Arvad/YbDDSControl/DDSbox/wiki_related/004_amplitude_tuning.jpg

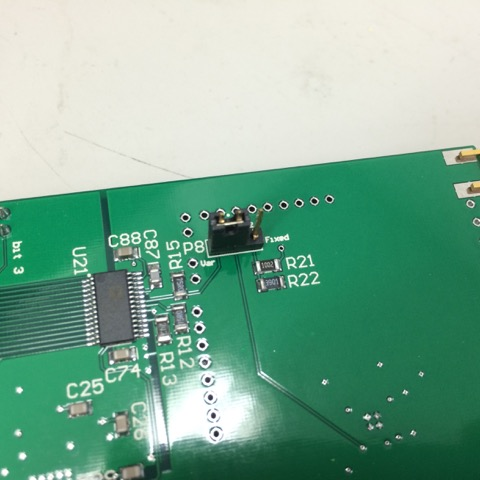
DDSbox/wiki_related/004_amplitude_tuning.jpg
