Arvad/YbDDSControl/DDSbox/wiki_related/gallery/UCLA_setup.jpg

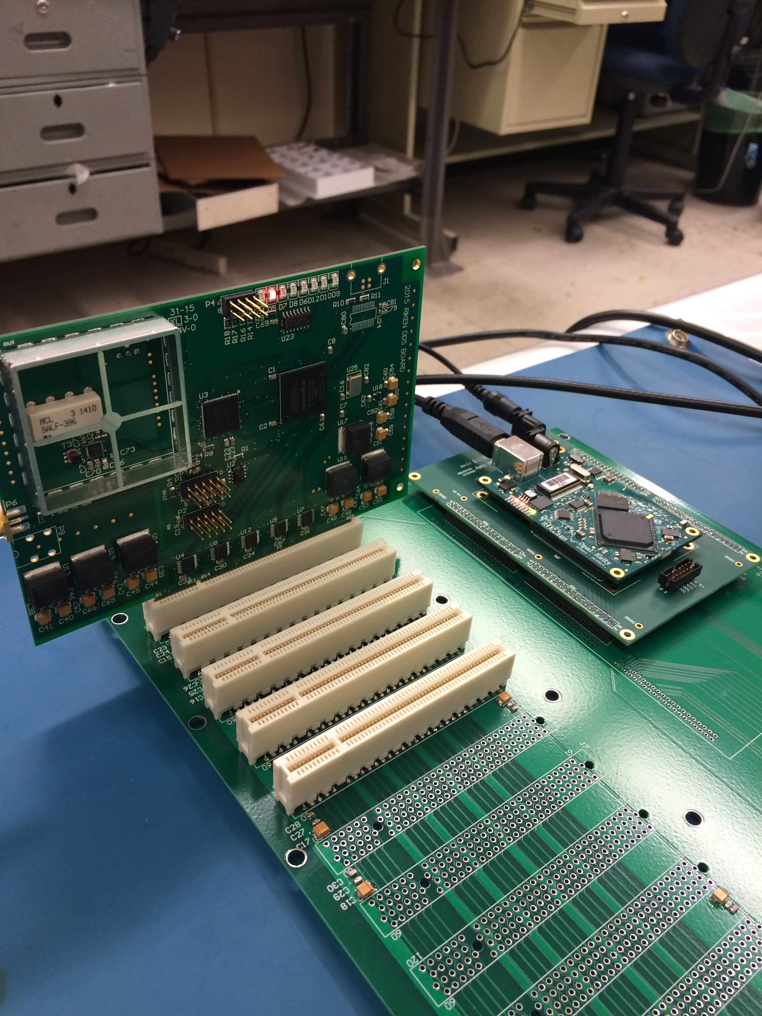
DDSbox/wiki_related/gallery/UCLA_setup.jpg
