Arvad/YbDDSControl/DDSbox/README.md

# Files for the DDS box (Both main Opal Kelly FPGA and dds boards (Cyclone FPGA))
Schematics
VhDl files
