Arvad/YbDDSControl/DDSbox/wiki_related/001_blank_LabRAD.tiff

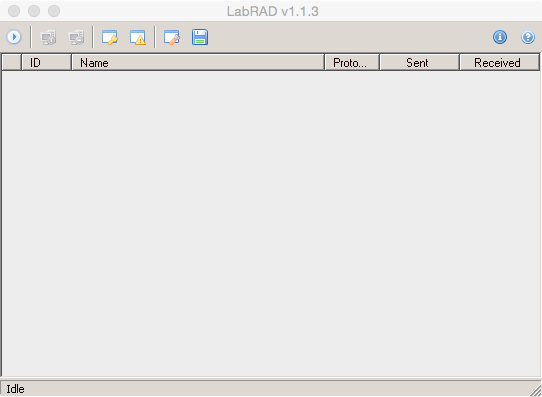
DDSbox/wiki_related/001_blank_LabRAD.tiff
