Arvad/YbDDSControl/DDSbox/wiki_related/002_initial_LabRAD.tiff

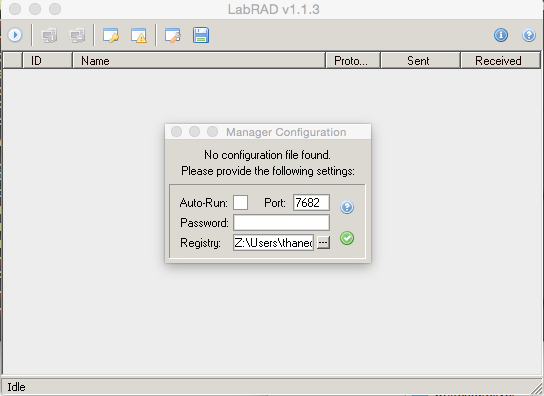
DDSbox/wiki_related/002_initial_LabRAD.tiff
