Arvad/YbDDSControl/DDSbox/wiki_related/005_DDS_GUI_sample.jpg

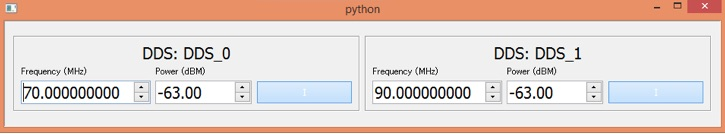
DDSbox/wiki_related/005_DDS_GUI_sample.jpg
