Arvad/YbDDSControl/DDSbox/wiki_related/006_frequency_ramp.jpg

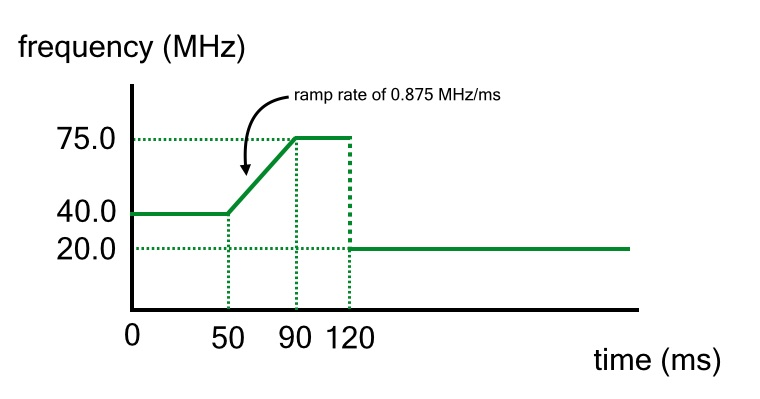
DDSbox/wiki_related/006_frequency_ramp.jpg
