Arvad/YbDDSControl/DDSbox/wiki_related/007_pin_connection.tiff

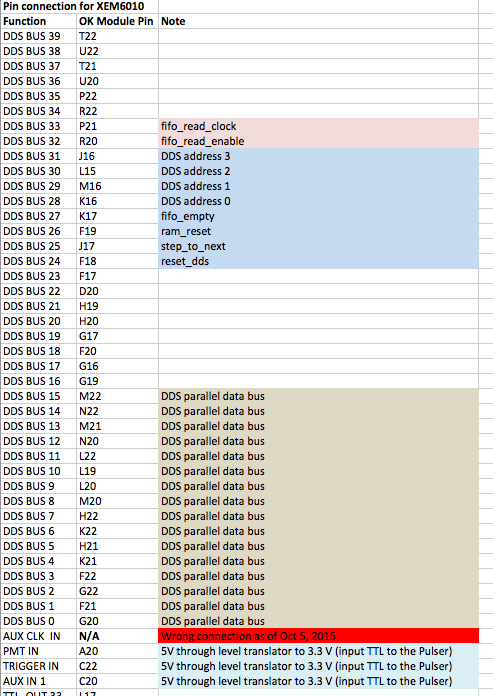
DDSbox/wiki_related/007_pin_connection.tiff
