Arvad/YbDDSControl/DDSbox/wiki_related/008_programming.tiff

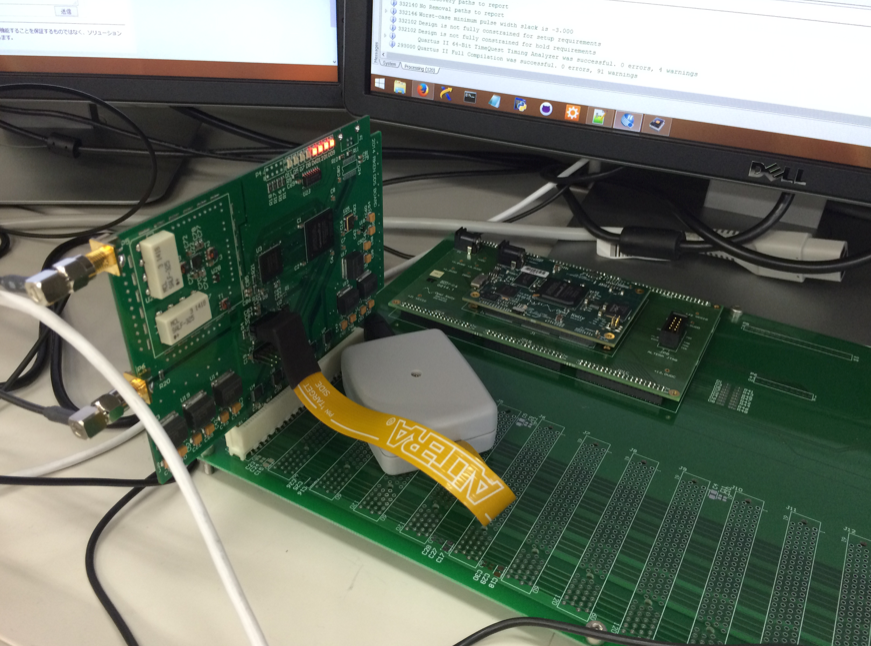
DDSbox/wiki_related/008_programming.tiff
