Arvad/YbDDSControl/DDSbox/wiki_related/010_moving_lattice_freq_curves.tiff

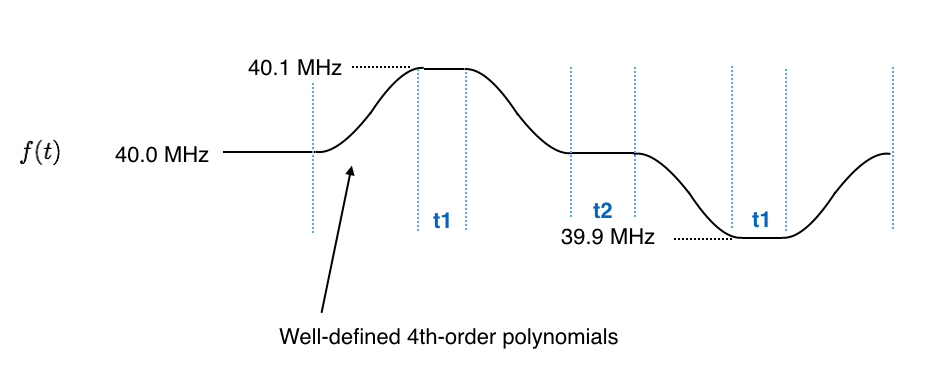
DDSbox/wiki_related/010_moving_lattice_freq_curves.tiff
