Arvad/YbDDSControl/DDSbox/wiki_related/011_moving_lattice_dds_boards.tiff

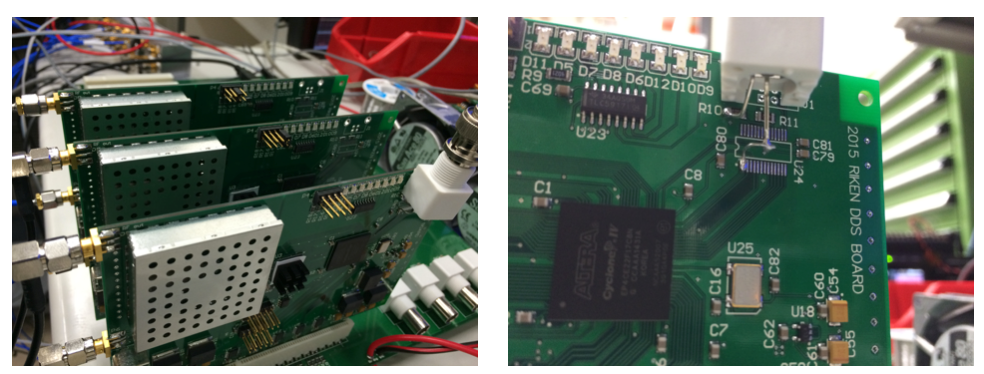
DDSbox/wiki_related/011_moving_lattice_dds_boards.tiff
