Arvad/YbDDSControl/DDSbox/wiki_related/gallery/Berkeley_2012.tiff

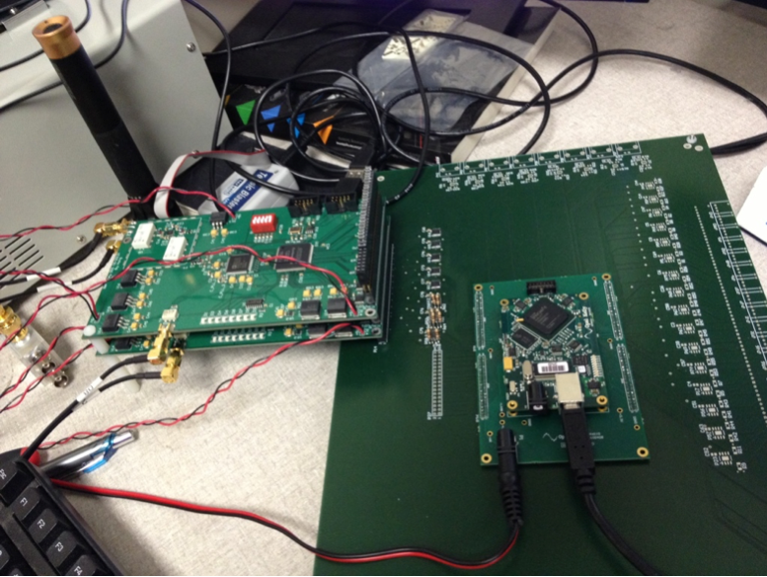
DDSbox/wiki_related/gallery/Berkeley_2012.tiff
