Arvad/YbDDSControl/DDSbox/wiki_related/gallery/Berkeley_2012_DDS_board.tiff

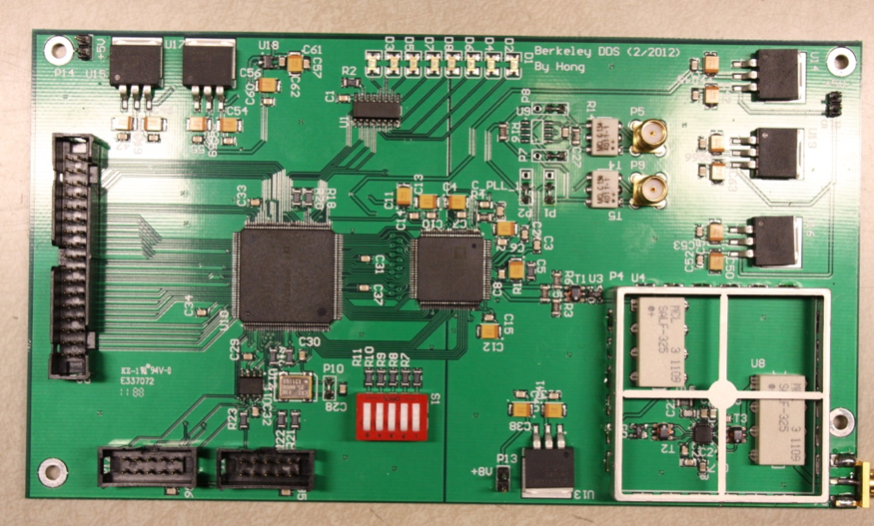
DDSbox/wiki_related/gallery/Berkeley_2012_DDS_board.tiff
