Arvad/YbDDSControl/DDSbox/wiki_related/gallery/RIKEN_2014_version.jpg

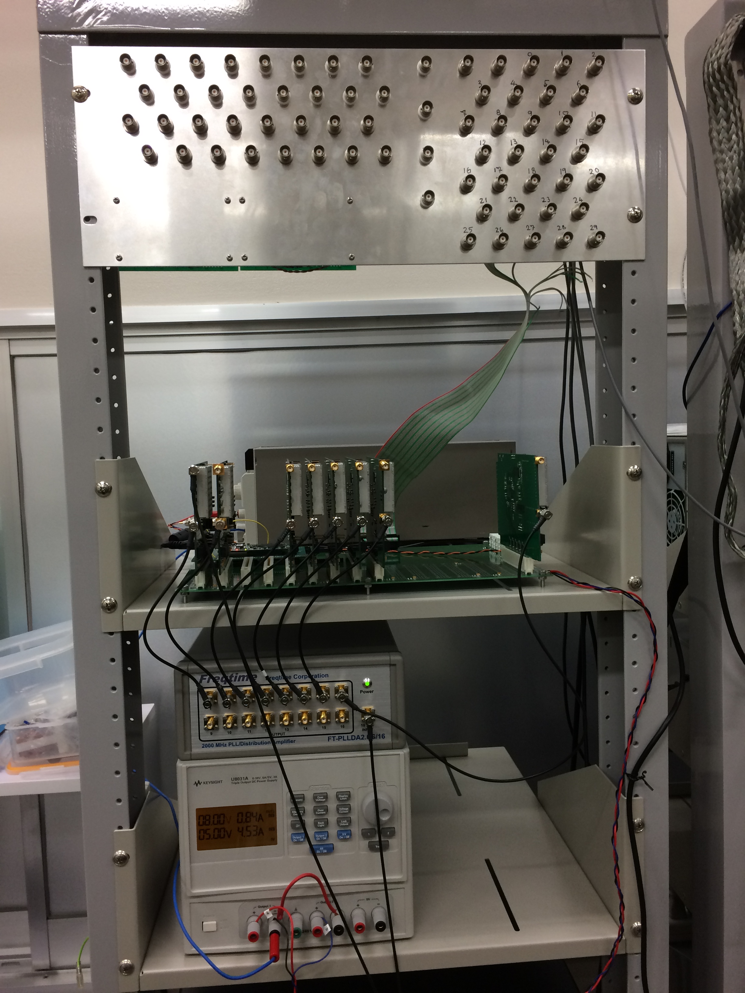
DDSbox/wiki_related/gallery/RIKEN_2014_version.jpg
