Arvad/YbDDSControl/DDSbox/PCB_designs/DDS_board/2016_Feb/Components_list.xlsx

DDS 2015 components list
No. of boards | 120
Components
Footprint | Description | Comment | Designator | Value | Quantity per board | Total quantity | Install? | Link | Arrived? | Arrived quantity | Required
CAPC2012L | Cap Semi |  | C1, C2, C3, C4, C5, C6, C7, C8, C9, C10, C15, C16, C17, C18, C19, C20, C21, C24, C25, C26, C27, C28, C29, C30, C31, C32, C33, C34, C35, C36, C37, C40, C41, C44, C45, C48, C49, C52, C53, C58, C59, C60, C61, C65, C66, C67, C68, C69, C70, C71, C72, C73, C75, C82 | 100nF | 54 | 6480 | Yes |  | Did not order
CAPC2012L | Cap Semi |  | C11, C12, C13, C14 | 10pF | 4 | 480 | Yes
CAPC2012L | Cap Semi |  | C22 | 560pF | 1 | 120 | Yes | http://www.digikey.jp/product-search/ja?KeyWords=399-9254-1-ND%20&WT.z_header=search_go
CAPC2012L | Cap Semi |  | C23 | 470nF | 1 | 120 | Yes
B | Cap Pol1 |  | C38, C39, C42, C43, C46, C47, C50, C51, C54, C55, C56, C57, C63, C64 | 10uF | 14 | 1680 | Yes | http://www.digikey.jp/product-detail/ja/T491B106M025AT/399-9721-1-ND/3724699 | Yes | 2000 | 560
CAPC2012L | Cap |  | C62 | 100nF | 1 | 120 | Yes |  |  |  | 40
c0805 | Cap |  | C74, C83, C84, C88 | 100nF | 4 | 480 | Yes |  |  |  | 160
c0805 | Cap |  | C76, C87 | 100pF | 2 | 240 | Yes |  |  |  | 80
c0805 | Cap |  | C77, C78 | 10nF | 2 | 240 | Yes | http://www.digikey.jp/product-search/ja?KeyWords=399-5706-1-ND%20&WT.z_header=search_go |  |  | 80
CAPC2012L | Cap Semi |  | C79, C80, C81 | 33nF | 3 | 360 | Yes |  |  |  | 120
c0805 | Cap | C0G special | C85, C86 | 47nF | 2 | 240 | Yes | http://www.digikey.jp/product-search/ja?KeyWords=399-8092-1-ND&WT.z_header=search_go | Yes | 100 | 80
CAPC2012L | Cap Semi |  | C89, C90, C91, C92, C93 | 330pF | 5 | 600 | Yes | http://www.digikey.jp/product-search/ja?KeyWords=399-1130-1-ND%20&WT.z_header=search_go | Yes | 600 | 200
SOD323 | 1PS76SB17 | Schottky Diode | D1, D2, D3, D4 |  | 4 | 480 | Yes | http://www.digikey.jp/product-detail/ja/1PS76SB17,115/568-6782-1-ND/2676822 | Yes | 500 | 160
DSO-C2/D5.6 | LED3 | Simple LED | D5, D6, D7, D8, D9, D10, D11, D12 |  | 8 | 960 | Yes | http://www.digikey.jp/product-detail/ja/SML-LX1206IC-TR/67-1356-1-ND/229203 | Yes | 1000 | 320
440119 | USB port |  | J1 |  | 1 | 120 | No |  |  |  | 40
PIN1 | Single pin |  | J2 |  | 1 | 120 | No |  |  |  | 40
HDR2X5 | JTAG |  | P1 |  | 1 | 120 | Yes | http://www.digikey.jp/product-search/ja?KeyWords=A26573-ND&WT.z_header=search_go |  |  | 40
HDR2X5 | ASCONFIG |  | P2 |  | 1 | 120 | Yes | http://www.digikey.jp/product-search/ja?KeyWords=A26573-ND&WT.z_header=search_go |  |  | 40
PCI3V32BIT | PCI3V32BIT | On-board | P3 |  | 1 | 120 | No |  |  |  | 40
HDR2X4 | DDS ADDRESS |  | P4 |  | 1 | 120 | Yes | http://www.digikey.jp/product-search/ja?KeyWords=A26570-ND&WT.z_header=search_go |  |  | 40
BMIS-207 | EMI sheild |  | P5 |  | 1 | 120 | Yes | http://www.digikey.jp/product-detail/ja/BMI-S-207-F/903-1056-1-ND/2182410 | Yes | 40 | 40
SMA_Edgecon_31milthick | RF_IN |  | P6 |  | 1 | 120 | No | http://www.digikey.jp/product-search/ja?x=0&y=0&lang=ja&site=jp&KeyWords=142-0711-821 | Yes |  | 40
SMA_Edgecon_31milthick | RF_OUT |  | P7 |  | 1 | 120 | No | http://www.digikey.jp/product-search/ja?x=0&y=0&lang=ja&site=jp&KeyWords=142-0711-821 | Yes |  | 40
HDR1X3 | Header 3 |  | P8 |  | 1 | 120 | Yes | http://www.digikey.jp/product-detail/ja/87224-3/A26545-ND/290802 | Yes | 120 | 40
RESC3216L | Resistor |  | R1, R2, R3, R4, R5, R6, R7, R10, R14, R16, R17, R18, R19, R21 | 10k | 14 | 1680 | Yes | http://www.digikey.jp/product-search/ja?KeyWords=RHM10.0KCJCT&WT.z_header=search_go | Yes | 1680 | 560
RESC3216L | Resistor |  | R8 | 3.3k | 1 | 120 | Yes | http://www.digikey.jp/product-search/ja?KeyWords=541-3.30KFCT&WT.z_header=search_go | Yes | 200 | 40
RESC3216L | Resistor |  | R9 | 4k | 1 | 120 | Yes | http://www.digikey.jp/product-search/ja?KeyWords=541-4.02KFCT&WT.z_header=search_go | Yes | 200 | 40
RESC3216L | Resistor |  | R11 | 4k7 | 1 | 120 | Yes |  |  |  | 40
RESC3216L | Resistor |  | R12, R15 | 75 | 2 | 240 | Yes | http://www.digikey.jp/product-search/ja?KeyWords=541-75.0FCT&WT.z_header=search_go | Yes | 240 | 80
RESC3216L | Resistor |  | R13 | 2k4 | 1 | 120 | Yes |  |  |  | 40
RESC3216L | Resistor |  | R20 | 50 | 1 | 120 | Yes | http://www.digikey.jp/product-search/ja?KeyWords=541-49.9FCT&WT.z_header=search_go |  |  | 40
RESC3216L | Resistor |  | R22 | 3k9 | 1 | 120 | Yes | http://www.digikey.jp/product-detail/ja/CRCW12063K90FKEA/541-3.90KFCT-ND/1181826 | Yes | 200 | 40
TC1-1TX+ | TC1-1TX+ |  | T3 |  | 1 | 120 | Yes | Mini-circuits |  |  | 40
FBGA256 | EP4CE22F17C8 |  | U1 |  | 1 | 120 | Yes | http://www.digikey.jp/product-detail/ja/EP4CE22F17C8N/544-2833-ND/2288348 |  |  | 40
SOIC8_L | EPCS16SI8N |  | U2 |  | 1 | 120 | Yes | http://www.digikey.jp/product-search/ja?KeyWords=EPCS16SI8N&WT.z_header=search_go |  |  | 40
CP_88_5 | AD9915BCPZ |  | U3 | Value | 1 | 120 | Yes | http://www.digikey.jp/product-detail/ja/AD9915BCPZ/AD9915BCPZ-ND/3602817 |  |  | 40
TSSOP16 | MAX3094 |  | U4, U5, U6, U8, U9, U10, U12, U20 |  | 8 | 960 | Yes | http://www.digikey.jp/product-detail/ja/MAX3094EEUE%2B/MAX3094EEUE%2B-ND/1513155 |  |  | 320
TSSOP16 | MAX3030 |  | U7, U11 |  | 2 | 240 | Yes | http://www.digikey.jp/product-detail/ja/MAX3030EEUE%2B/MAX3030EEUE%2B-ND/1514304 |  |  | 80
TS3B_N | LM1086IS-5.0 |  | U13 |  | 1 | 120 | Yes | http://www.digikey.jp/product-detail/ja/LM1086ISX-5.0%2FNOPB/LM1086ISX-5.0%2FNOPBCT-ND/3526812 | Yes | 50 | 40
TS3B_N | LM1086IS-3.3 |  | U14, U17 |  | 2 | 240 | Yes | http://www.digikey.jp/product-detail/ja/LM1086ISX-3.3%2FNOPB/LM1086ISX-3.3%2FNOPBCT-ND/3440097 | Yes | 100 | 80
TS3B_N | LM1086IS-1.8 |  | U15, U19 |  | 2 | 240 | Yes | http://www.digikey.jp/product-detail/ja/LM1086ISX-1.8%2FNOPB/LM1086ISX-1.8%2FNOPBCT-ND/3526811 | Yes | 100 | 80
TS3B_N | LM1086CS-2.5 |  | U16 |  | 1 | 120 | Yes | http://www.digikey.jp/product-detail/ja/LM1086CS-2.5%2FNOPB/LM1086CS-2.5%2FNOPB-ND/440992 |  |  | 40
MF05A_N | LP2983AIM5-1.2 |  | U18 |  | 1 | 120 | Yes | http://www.digikey.jp/product-detail/ja/LP2983AIM5-1.2%2FNOPB/LP2983AIM5-1.2%2FNOPBCT-ND/562198 | Yes | 50 | 40
TSOP65P640-28AM | AD9744 |  | U21 |  | 1 | 120 | Yes | http://www.digikey.jp/product-detail/ja/AD9744ARUZ/AD9744ARUZ-ND/936549 |  |  | 40
QFN50P400X400-24VAN | ADL5330 |  | U22 |  | 1 | 120 | Yes | http://www.digikey.jp/product-detail/ja/ADL5330ACPZ-REEL7/ADL5330ACPZ-REEL7CT-ND/1657728 |  |  | 40
D016_N | TLC5917 | LED driver | U23 |  | 1 | 120 | Yes | http://www.digikey.jp/product-detail/ja/TLC5917IDR/296-21995-1-ND/1643154 | Yes | 40 | 40
DB028 | IC_FT245RL |  | U24 |  | 1 | 120 | No | http://www.digikey.jp/product-detail/ja/FT245RL-REEL/768-1011-1-ND/1836406 |  |  | 40
CSX750F | CSX750F_25 |  | U25 |  | 1 | 120 | Yes | http://www.digikey.jp/product-detail/ja/CSX750FBC24.000MT/300-7244-1-ND/482132 | Yes | 40 | 40
SALF-396 | SALF-396 |  | U26 |  | 1 | 120 | Yes | Mini-circuits |  |  | 40
Additional parts
EMC cover |  |  |  |  | 1 |  |  | http://www.digikey.jp/product-search/ja?vendor=0&keywords=903-1019-ND
Jumper shorting |  |  |  |  | 2 |  |  | http://www.digikey.jp/product-detail/ja/QPC02SXGN-RC/S9337-ND/2618262
