Arvad/YbDDSControl/DDSbox/VHDL_files/Pulser_w_2016_06_10/photon/photon_pad.csv

#Release 14.7 - par P.20131013 (nt)
#Copyright (c) 1995-2013 Xilinx | Inc. All rights reserved.
#Thu Sep 15 10:50:33 2016
#
## NOTE: This file is designed to be imported into a spreadsheet program
# such as Microsoft Excel for viewing | printing and sorting. The
# character is used as the data field separator. This file is also designed
# to support parsing.
#
#INPUT FILE: photon_map.ncd
#OUTPUT FILE: photon_pad.csv
#PART TYPE: xc6slx45
#SPEED GRADE: -2
#PACKAGE: fgg484
#
# Pinout by Pin Number:
#
# ----- | ----- | ----- | ----- | ----- | ----- | ----- | ----- | ----- | ----- | ----- | ----- | ----- | ----- | -----
Pin Number | Signal Name | Pin Usage | Pin Name | Direction | IO Standard | IO Bank Number | Drive (mA) | Slew Rate | Termination | IOB Delay | Voltage | Constraint | IO Register | Signal Integrity
A1 |  |  | GND
A2 |  | IOBM | IO_L83P_3 | UNUSED |  | 3
A3 | logic_out<25> | IOB | IO_L1P_HSWAPEN_0 | OUTPUT | LVCMOS33 | 0 | 12 | SLOW |  |  |  | LOCATED | NO | NONE
A4 | logic_out<23> | IOB | IO_L1N_VREF_0 | OUTPUT | LVCMOS33 | 0 | 12 | SLOW |  |  |  | LOCATED | NO | NONE
A5 |  | IOBS | IO_L2N_0 | UNUSED |  | 0
A6 | logic_out<22> | IOB | IO_L4N_0 | OUTPUT | LVCMOS33 | 0 | 12 | SLOW |  |  |  | LOCATED | NO | NONE
A7 | logic_out<18> | IOB | IO_L5N_0 | OUTPUT | LVCMOS33 | 0 | 12 | SLOW |  |  |  | LOCATED | NO | NONE
A8 | logic_out<19> | IOB | IO_L6N_0 | OUTPUT | LVCMOS33 | 0 | 12 | SLOW |  |  |  | LOCATED | NO | NONE
A9 | logic_out<14> | IOB | IO_L8N_VREF_0 | OUTPUT | LVCMOS33 | 0 | 12 | SLOW |  |  |  | LOCATED | NO | NONE
A10 | logic_out<15> | IOB | IO_L34N_GCLK18_0 | OUTPUT | LVCMOS33 | 0 | 12 | SLOW |  |  |  | LOCATED | NO | NONE
A11 |  | IOBS | IO_L35N_GCLK16_0 | UNUSED |  | 0
A12 | logic_out<10> | IOB | IO_L37N_GCLK12_0 | OUTPUT | LVCMOS33 | 0 | 12 | SLOW |  |  |  | LOCATED | NO | NONE
A13 | logic_out<11> | IOB | IO_L38N_VREF_0 | OUTPUT | LVCMOS33 | 0 | 12 | SLOW |  |  |  | LOCATED | NO | NONE
A14 | logic_out<6> | IOB | IO_L50N_0 | OUTPUT | LVCMOS33 | 0 | 12 | SLOW |  |  |  | LOCATED | NO | NONE
A15 | logic_out<7> | IOB | IO_L51N_0 | OUTPUT | LVCMOS33 | 0 | 12 | SLOW |  |  |  | LOCATED | NO | NONE
A16 | logic_out<2> | IOB | IO_L63N_SCP6_0 | OUTPUT | LVCMOS33 | 0 | 12 | SLOW |  |  |  | LOCATED | NO | NONE
A17 | logic_out<3> | IOB | IO_L64N_SCP4_0 | OUTPUT | LVCMOS33 | 0 | 12 | SLOW |  |  |  | LOCATED | NO | NONE
A18 | logic_out<1> | IOB | IO_L65N_SCP2_0 | OUTPUT | LVCMOS33 | 0 | 12 | SLOW |  |  |  | LOCATED | NO | NONE
A19 |  |  | TDO
A20 | pmt_input | IOB | IO_L20P_1 | INPUT | LVCMOS33 | 1 |  |  |  | NONE |  | LOCATED | NO | NONE
A21 |  | IOBS | IO_L20N_1 | UNUSED |  | 1
A22 |  |  | GND
AA1 |  |  | PROGRAM_B_2
AA2 | hi_inout<7> | IOB | IO_L64P_D8_2 | BIDIR | LVCMOS33 | 2 | 12 | SLOW |  | NONE |  | LOCATED | YES | NONE
AA3 |  |  | VCCO_2 |  |  | 2 |  |  |  |  | 3.30
AA4 | hi_in<4> | IOB | IO_L57P_2 | INPUT | LVCMOS33 | 2 |  |  |  | NONE |  | LOCATED | NO | NONE
AA5 |  |  | GND
AA6 | hi_inout<12> | IOB | IO_L49P_D3_2 | BIDIR | LVCMOS33 | 2 | 12 | SLOW |  | NONE |  | LOCATED | YES | NONE
AA7 |  |  | VCCO_2 |  |  | 2 |  |  |  |  | 3.30
AA8 | hi_out<1> | IOB | IO_L45P_2 | OUTPUT | LVCMOS33 | 2 | 12 | SLOW |  |  |  | LOCATED | NO | NONE
AA9 |  |  | GND
AA10 | led<6> | IOB | IO_L41P_2 | OUTPUT | LVCMOS33 | 2 | 12 | SLOW |  |  |  | LOCATED | NO | NONE
AA11 |  |  | VCCO_2 |  |  | 2 |  |  |  |  | 3.30
AA12 | hi_inout<1> | IOB | IO_L31P_GCLK31_D14_2 | BIDIR | LVCMOS33 | 2 | 12 | SLOW |  | NONE |  | LOCATED | YES | NONE
AA13 |  |  | GND
AA14 | led<2> | IOB | IO_L16P_2 | OUTPUT | LVCMOS33 | 2 | 12 | SLOW |  |  |  | LOCATED | NO | NONE
AA15 |  |  | VCCO_2 |  |  | 2 |  |  |  |  | 3.30
AA16 | led<4> | IOB | IO_L19P_2 | OUTPUT | LVCMOS33 | 2 | 12 | SLOW |  |  |  | LOCATED | NO | NONE
AA17 |  |  | GND
AA18 | hi_inout<4> | IOB | IO_L14P_D11_2 | BIDIR | LVCMOS33 | 2 | 12 | SLOW |  | NONE |  | LOCATED | YES | NONE
AA19 |  |  | VCCO_2 |  |  | 2 |  |  |  |  | 3.30
AA20 | hi_inout<15> | IOB | IO_L3P_D0_DIN_MISO_MISO1_2 | BIDIR | LVCMOS33 | 2 | 12 | SLOW |  | NONE |  | LOCATED | YES | NONE
AA21 |  | IOBM | IO_L2P_CMPCLK_2 | UNUSED |  | 2
AA22 | hi_muxsel | IOB | IO_L1N_M0_CMPMISO_2 | OUTPUT | LVCMOS33 | 2 | 12 | SLOW |  |  |  | LOCATED | NO | NONE
AB1 |  |  | GND
AB2 | hi_inout<6> | IOB | IO_L64N_D9_2 | BIDIR | LVCMOS33 | 2 | 12 | SLOW |  | NONE |  | LOCATED | YES | NONE
AB3 | hi_in<7> | IOB | IO_L58N_2 | INPUT | LVCMOS33 | 2 |  |  |  | NONE |  | LOCATED | NO | NONE
AB4 | hi_in<5> | IOB | IO_L57N_2 | INPUT | LVCMOS33 | 2 |  |  |  | NONE |  | LOCATED | NO | NONE
AB5 |  | IOBS | IO_L54N_2 | UNUSED |  | 2
AB6 | hi_inout<11> | IOB | IO_L49N_D4_2 | BIDIR | LVCMOS33 | 2 | 12 | SLOW |  | NONE |  | LOCATED | YES | NONE
AB7 | hi_in<2> | IOB | IO_L48N_RDWR_B_VREF_2 | INPUT | LVCMOS33 | 2 |  |  |  | NONE |  | LOCATED | NO | NONE
AB8 | hi_in<3> | IOB | IO_L45N_2 | INPUT | LVCMOS33 | 2 |  |  |  | NONE |  | LOCATED | NO | NONE
AB9 | i2c_sda | IOB | IO_L43N_2 | TRISTATE | LVCMOS33 | 2 | 12 | SLOW | PULLUP |  |  | LOCATED | NO | NONE
AB10 | led<7> | IOB | IO_L41N_VREF_2 | OUTPUT | LVCMOS33 | 2 | 12 | SLOW |  |  |  | LOCATED | NO | NONE
AB11 |  | IOBS | IO_L32N_GCLK28_2 | UNUSED |  | 2
AB12 | hi_inout<0> | IOB | IO_L31N_GCLK30_D15_2 | BIDIR | LVCMOS33 | 2 | 12 | SLOW |  | NONE |  | LOCATED | YES | NONE
AB13 | clk1 | IOB | IO_L30N_GCLK0_USERCCLK_2 | INPUT | LVCMOS33 | 2 |  |  |  | NONE |  | LOCATED | NO | NONE
AB14 | led<3> | IOB | IO_L16N_VREF_2 | OUTPUT | LVCMOS33 | 2 | 12 | SLOW |  |  |  | LOCATED | NO | NONE
AB15 |  | IOBS | IO_L21N_2 | UNUSED |  | 2
AB16 | led<5> | IOB | IO_L19N_2 | OUTPUT | LVCMOS33 | 2 | 12 | SLOW |  |  |  | LOCATED | NO | NONE
AB17 | led<1> | IOB | IO_L15N_2 | OUTPUT | LVCMOS33 | 2 | 12 | SLOW |  |  |  | LOCATED | NO | NONE
AB18 | hi_inout<3> | IOB | IO_L14N_D12_2 | BIDIR | LVCMOS33 | 2 | 12 | SLOW |  | NONE |  | LOCATED | YES | NONE
AB19 |  | IOBS | IO_L5N_2 | UNUSED |  | 2
AB20 | hi_in<1> | IOB | IO_L3N_MOSI_CSI_B_MISO0_2 | INPUT | LVCMOS33 | 2 |  |  |  | NONE |  | LOCATED | NO | NONE
AB21 |  | IOBS | IO_L2N_CMPMOSI_2 | UNUSED |  | 2
AB22 |  |  | GND
B1 |  | IOBS | IO_L60N_3 | UNUSED |  | 3
B2 |  | IOBM | IO_L60P_3 | UNUSED |  | 3
B3 |  | IOBS | IO_L83N_VREF_3 | UNUSED |  | 3
B4 |  |  | VCCO_0 |  |  | 0 |  |  |  |  | 3.30
B5 |  |  | GND
B6 | logic_out<24> | IOB | IO_L4P_0 | OUTPUT | LVCMOS33 | 0 | 12 | SLOW |  |  |  | LOCATED | NO | NONE
B7 |  |  | VCCO_0 |  |  | 0 |  |  |  |  | 3.30
B8 | logic_out<21> | IOB | IO_L6P_0 | OUTPUT | LVCMOS33 | 0 | 12 | SLOW |  |  |  | LOCATED | NO | NONE
B9 |  |  | GND
B10 | logic_out<17> | IOB | IO_L34P_GCLK19_0 | OUTPUT | LVCMOS33 | 0 | 12 | SLOW |  |  |  | LOCATED | NO | NONE
B11 |  |  | VCCO_0 |  |  | 0 |  |  |  |  | 3.30
B12 | logic_out<12> | IOB | IO_L37P_GCLK13_0 | OUTPUT | LVCMOS33 | 0 | 12 | SLOW |  |  |  | LOCATED | NO | NONE
B13 |  |  | GND
B14 | logic_out<8> | IOB | IO_L50P_0 | OUTPUT | LVCMOS33 | 0 | 12 | SLOW |  |  |  | LOCATED | NO | NONE
B15 |  |  | VCCO_0 |  |  | 0 |  |  |  |  | 3.30
B16 | logic_out<4> | IOB | IO_L63P_SCP7_0 | OUTPUT | LVCMOS33 | 0 | 12 | SLOW |  |  |  | LOCATED | NO | NONE
B17 |  |  | GND
B18 | logic_out<0> | IOB | IO_L65P_SCP3_0 | OUTPUT | LVCMOS33 | 0 | 12 | SLOW |  |  |  | LOCATED | NO | NONE
B19 |  |  | VCCO_0 |  |  | 0 |  |  |  |  | 3.30
B20 |  | IOBS | IO_L1N_A24_VREF_1 | UNUSED |  | 1
B21 |  | IOBM | IO_L19P_1 | UNUSED |  | 1
B22 |  | IOBS | IO_L19N_1 | UNUSED |  | 1
C1 |  | IOBS | IO_L54N_M3A11_3 | UNUSED |  | 3
C2 |  |  | VCCO_3 |  |  | 3 |  |  |  |  | any******
C3 |  | IOBM | IO_L54P_M3RESET_3 | UNUSED |  | 3
C4 |  | IOBS | IO_L81N_3 | UNUSED |  | 3
C5 |  | IOBM | IO_L2P_0 | UNUSED |  | 0
C6 | logic_out<27> | IOB | IO_L3N_0 | OUTPUT | LVCMOS33 | 0 | 12 | SLOW |  |  |  | LOCATED | NO | NONE
C7 | logic_out<20> | IOB | IO_L5P_0 | OUTPUT | LVCMOS33 | 0 | 12 | SLOW |  |  |  | LOCATED | NO | NONE
C8 | logic_in<2> | IOB | IO_L7N_0 | INPUT | LVCMOS33 | 0 |  |  |  | NONE |  | LOCATED | NO | NONE
C9 | logic_out<16> | IOB | IO_L8P_0 | OUTPUT | LVCMOS33 | 0 | 12 | SLOW |  |  |  | LOCATED | NO | NONE
C10 |  | IOBS | IO_L33N_0 | UNUSED |  | 0
C11 |  | IOBM | IO_L35P_GCLK17_0 | UNUSED |  | 0
C12 | logic_out<30> | IOB | IO_L36N_GCLK14_0 | OUTPUT | LVCMOS33 | 0 | 12 | SLOW |  |  |  | LOCATED | NO | NONE
C13 | logic_out<13> | IOB | IO_L38P_0 | OUTPUT | LVCMOS33 | 0 | 12 | SLOW |  |  |  | LOCATED | NO | NONE
C14 |  | IOBS | IO_L49N_0 | UNUSED |  | 0
C15 | logic_out<9> | IOB | IO_L51P_0 | OUTPUT | LVCMOS33 | 0 | 12 | SLOW |  |  |  | LOCATED | NO | NONE
C16 | logic_out<26> | IOB | IO_L62N_VREF_0 | OUTPUT | LVCMOS33 | 0 | 12 | SLOW |  |  |  | LOCATED | NO | NONE
C17 | logic_out<5> | IOB | IO_L64P_SCP5_0 | OUTPUT | LVCMOS33 | 0 | 12 | SLOW |  |  |  | LOCATED | NO | NONE
C18 |  |  | TMS
C19 |  | IOBM | IO_L1P_A25_1 | UNUSED |  | 1
C20 |  | IOBM | IO_L32P_A17_M1A8_1 | UNUSED |  | 1
C21 |  |  | VCCO_1 |  |  | 1 |  |  |  |  | 3.30
C22 | logic_in<0> | IOB | IO_L32N_A16_M1A9_1 | INPUT | LVCMOS33 | 1 |  |  |  | NONE |  | LOCATED | NO | NONE
D1 |  | IOBS | IO_L53N_M3A12_3 | UNUSED |  | 3
D2 |  | IOBM | IO_L53P_M3CKE_3 | UNUSED |  | 3
D3 |  | IOBM | IO_L81P_3 | UNUSED |  | 3
D4 |  |  | GND
D5 |  | IOBM | IO_L58P_3 | UNUSED |  | 3
D6 | logic_out<29> | IOB | IO_L3P_0 | OUTPUT | LVCMOS33 | 0 | 12 | SLOW |  |  |  | LOCATED | NO | NONE
D7 | logic_in<1> | IOB | IO_L32P_0 | INPUT | LVCMOS33 | 0 |  |  |  | NONE |  | LOCATED | NO | NONE
D8 |  | IOBS | IO_L32N_0 | UNUSED |  | 0
D9 |  | IOBM | IO_L7P_0 | UNUSED |  | 0
D10 |  | IOBM | IO_L33P_0 | UNUSED |  | 0
D11 |  | IOBM | IO_L36P_GCLK15_0 | UNUSED |  | 0
D12 |  |  | NC
D13 |  |  | NC
D14 |  | IOBM | IO_L49P_0 | UNUSED |  | 0
D15 | logic_out<28> | IOB | IO_L62P_0 | OUTPUT | LVCMOS33 | 0 | 12 | SLOW |  |  |  | LOCATED | NO | NONE
D16 |  |  | VCCAUX |  |  |  |  |  |  |  | 3.3
D17 | logic_in<3> | IOB | IO_L66N_SCP0_0 | INPUT | LVCMOS33 | 0 |  |  |  | NONE |  | LOCATED | NO | NONE
D18 |  |  | GND
D19 |  | IOBM | IO_L29P_A23_M1A13_1 | UNUSED |  | 1
D20 | dds_logic_debug_out<6> | IOB | IO_L29N_A22_M1A14_1 | OUTPUT | LVCMOS33 | 1 | 12 | SLOW |  |  |  | LOCATED | NO | NONE
D21 |  | IOBM | IO_L31P_A19_M1CKE_1 | UNUSED |  | 1
D22 |  | IOBS | IO_L31N_A18_M1A12_1 | UNUSED |  | 1
E1 |  | IOBS | IO_L52N_M3A9_3 | UNUSED |  | 3
E2 |  |  | GND
E3 |  | IOBM | IO_L52P_M3A8_3 | UNUSED |  | 3
E4 |  | IOBS | IO_L58N_3 | UNUSED |  | 3
E5 |  | IOBM | IO_L82P_3 | UNUSED |  | 3
E6 |  | IOBS | IO_L82N_3 | UNUSED |  | 3
E7 |  |  | GND
E8 |  |  | NC
E9 |  |  | VCCO_0 |  |  | 0 |  |  |  |  | 3.30
E10 |  |  | NC
E11 |  |  | GND
E12 |  |  | NC
E13 |  |  | VCCO_0 |  |  | 0 |  |  |  |  | 3.30
E14 |  |  | NC
E15 |  |  | GND
E16 |  | IOBM | IO_L66P_SCP1_0 | UNUSED |  | 0
E17 |  |  | VCCO_0 |  |  | 0 |  |  |  |  | 3.30
E18 |  |  | TDI
E19 |  |  | VCCO_1 |  |  | 1 |  |  |  |  | 3.30
E20 |  | IOBM | IO_L35P_A11_M1A7_1 | UNUSED |  | 1
E21 |  |  | GND
E22 |  | IOBS | IO_L35N_A10_M1A2_1 | UNUSED |  | 1
F1 |  | IOBS | IO_L50N_M3BA2_3 | UNUSED |  | 3
F2 |  | IOBM | IO_L50P_M3WE_3 | UNUSED |  | 3
F3 |  | IOBS | IO_L51N_M3A4_3 | UNUSED |  | 3
F4 |  |  | VCCO_3 |  |  | 3 |  |  |  |  | any******
F5 |  | IOBS | IO_L55N_M3A14_3 | UNUSED |  | 3
F6 |  |  | VCCO_3 |  |  | 3 |  |  |  |  | any******
F7 |  | IOBS | IO_L80N_3 | UNUSED |  | 3
F8 |  |  | NC
F9 |  |  | NC
F10 |  |  | NC
F11 |  |  | VCCAUX |  |  |  |  |  |  |  | 3.3
F12 |  |  | NC
F13 |  |  | NC
F14 |  |  | NC
F15 |  |  | NC
F16 |  | IOBM | IO_L10P_1 | UNUSED |  | 1
F17 | dds_logic_debug_out<7> | IOB | IO_L10N_1 | OUTPUT | LVCMOS33 | 1 | 12 | SLOW |  |  |  | LOCATED | NO | NONE
F18 | dds_logic_reset_dds_chip | IOB | IO_L30P_A21_M1RESET_1 | OUTPUT | LVCMOS33 | 1 | 12 | SLOW |  |  |  | LOCATED | NO | NONE
F19 | dds_logic_ram_reset | IOB | IO_L30N_A20_M1A11_1 | OUTPUT | LVCMOS33 | 1 | 12 | SLOW |  |  |  | LOCATED | NO | NONE
F20 | dds_logic_debug_out<2> | IOB | IO_L33N_A14_M1A4_1 | OUTPUT | LVCMOS33 | 1 | 12 | SLOW |  |  |  | LOCATED | NO | NONE
F21 | dds_logic_data_out<1> | IOB | IO_L37P_A7_M1A0_1 | OUTPUT | LVCMOS33 | 1 | 12 | SLOW |  |  |  | LOCATED | NO | NONE
F22 | dds_logic_data_out<3> | IOB | IO_L37N_A6_M1A1_1 | OUTPUT | LVCMOS33 | 1 | 12 | SLOW |  |  |  | LOCATED | NO | NONE
G1 |  | IOBS | IO_L48N_M3BA1_3 | UNUSED |  | 3
G2 |  |  | VCCO_3 |  |  | 3 |  |  |  |  | any******
G3 |  | IOBM | IO_L48P_M3BA0_3 | UNUSED |  | 3
G4 |  | IOBM | IO_L51P_M3A10_3 | UNUSED |  | 3
G5 |  |  | GND
G6 |  | IOBM | IO_L55P_M3A13_3 | UNUSED |  | 3
G7 |  | IOBM | IO_L80P_3 | UNUSED |  | 3
G8 |  |  | NC
G9 |  |  | NC
G10 |  |  | VCCO_0 |  |  | 0 |  |  |  |  | 3.30
G11 |  |  | NC
G12 |  |  | VCCAUX |  |  |  |  |  |  |  | 3.3
G13 |  |  | NC
G14 |  |  | VCCO_0 |  |  | 0 |  |  |  |  | 3.30
G15 |  |  | TCK
G16 | dds_logic_debug_out<1> | IOB | IO_L9P_1 | OUTPUT | LVCMOS33 | 1 | 12 | SLOW |  |  |  | LOCATED | NO | NONE
G17 | dds_logic_debug_out<3> | IOB | IO_L9N_1 | OUTPUT | LVCMOS33 | 1 | 12 | SLOW |  |  |  | LOCATED | NO | NONE
G18 |  |  | GND
G19 | dds_logic_debug_out<0> | IOB | IO_L33P_A15_M1A10_1 | OUTPUT | LVCMOS33 | 1 | 12 | SLOW |  |  |  | LOCATED | NO | NONE
G20 | dds_logic_data_out<0> | IOB | IO_L39P_M1A3_1 | OUTPUT | LVCMOS33 | 1 | 12 | SLOW |  |  |  | LOCATED | NO | NONE
G21 |  |  | VCCO_1 |  |  | 1 |  |  |  |  | 3.30
G22 | dds_logic_data_out<2> | IOB | IO_L39N_M1ODT_1 | OUTPUT | LVCMOS33 | 1 | 12 | SLOW |  |  |  | LOCATED | NO | NONE
H1 |  | IOBS | IO_L47N_M3A1_3 | UNUSED |  | 3
H2 |  | IOBM | IO_L47P_M3A0_3 | UNUSED |  | 3
H3 |  | IOBS | IO_L46N_M3CLKN_3 | UNUSED |  | 3
H4 |  | IOBM | IO_L46P_M3CLK_3 | UNUSED |  | 3
H5 |  | IOBS | IO_L49N_M3A2_3 | UNUSED |  | 3
H6 |  | IOBM | IO_L49P_M3A7_3 | UNUSED |  | 3
H7 |  |  | GND
H8 |  | IOBS | IO_L59N_3 | UNUSED |  | 3
H9 |  |  | VCCAUX |  |  |  |  |  |  |  | 3.3
H10 |  |  | NC
H11 |  |  | NC
H12 |  |  | NC
H13 |  |  | NC
H14 |  |  | NC
H15 |  |  | VCCAUX |  |  |  |  |  |  |  | 3.3
H16 |  | IOBM | IO_L28P_1 | UNUSED |  | 1
H17 |  | IOBS | IO_L28N_VREF_1 | UNUSED |  | 1
H18 |  | IOBS | IO_L34N_A12_M1BA2_1 | UNUSED |  | 1
H19 | dds_logic_debug_out<5> | IOB | IO_L34P_A13_M1WE_1 | OUTPUT | LVCMOS33 | 1 | 12 | SLOW |  |  |  | LOCATED | NO | NONE
H20 | dds_logic_debug_out<4> | IOB | IO_L38P_A5_M1CLK_1 | OUTPUT | LVCMOS33 | 1 | 12 | SLOW |  |  |  | LOCATED | NO | NONE
H21 | dds_logic_data_out<5> | IOB | IO_L41P_GCLK9_IRDY1_M1RASN_1 | OUTPUT | LVCMOS33 | 1 | 12 | SLOW |  |  |  | LOCATED | NO | NONE
H22 | dds_logic_data_out<7> | IOB | IO_L41N_GCLK8_M1CASN_1 | OUTPUT | LVCMOS33 | 1 | 12 | SLOW |  |  |  | LOCATED | NO | NONE
J1 |  | IOBS | IO_L41N_GCLK26_M3DQ5_3 | UNUSED |  | 3
J2 |  |  | GND
J3 |  | IOBM | IO_L41P_GCLK27_M3DQ4_3 | UNUSED |  | 3
J4 |  | IOBS | IO_L44N_GCLK20_M3A6_3 | UNUSED |  | 3
J5 |  |  | VCCO_3 |  |  | 3 |  |  |  |  | any******
J6 |  | IOBS | IO_L45N_M3ODT_3 | UNUSED |  | 3
J7 |  | IOBM | IO_L59P_3 | UNUSED |  | 3
J8 |  |  | VCCINT |  |  |  |  |  |  |  | 1.2
J9 |  |  | GND
J10 |  |  | VCCINT |  |  |  |  |  |  |  | 1.2
J11 |  |  | GND
J12 |  |  | VCCINT |  |  |  |  |  |  |  | 1.2
J13 |  |  | GND
J14 |  |  | VCCINT |  |  |  |  |  |  |  | 1.2
J15 |  |  | GND
J16 | dds_logic_address<3> | IOB | IO_L21N_1 | OUTPUT | LVCMOS33 | 1 | 12 | SLOW |  |  |  | LOCATED | NO | NONE
J17 | dds_logic_step_to_next_value | IOB | IO_L36P_A9_M1BA0_1 | OUTPUT | LVCMOS33 | 1 | 12 | SLOW |  |  |  | LOCATED | NO | NONE
J18 |  |  | VCCO_1 |  |  | 1 |  |  |  |  | 3.30
J19 |  | IOBS | IO_L38N_A4_M1CLKN_1 | UNUSED |  | 1
J20 |  | IOBM | IO_L43P_GCLK5_M1DQ4_1 | UNUSED |  | 1
J21 |  |  | GND
J22 |  | IOBS | IO_L43N_GCLK4_M1DQ5_1 | UNUSED |  | 1
K1 |  | IOBS | IO_L40N_M3DQ7_3 | UNUSED |  | 3
K2 |  | IOBM | IO_L40P_M3DQ6_3 | UNUSED |  | 3
K3 |  | IOBM | IO_L44P_GCLK21_M3A5_3 | UNUSED |  | 3
K4 |  | IOBS | IO_L43N_GCLK22_IRDY2_M3CASN_3 | UNUSED |  | 3
K5 |  | IOBM | IO_L43P_GCLK23_M3RASN_3 | UNUSED |  | 3
K6 |  | IOBM | IO_L45P_M3A3_3 | UNUSED |  | 3
K7 |  | IOBM | IO_L57P_3 | UNUSED |  | 3
K8 |  | IOBS | IO_L57N_VREF_3 | UNUSED |  | 3
K9 |  |  | VCCINT |  |  |  |  |  |  |  | 1.2
K10 |  |  | GND
K11 |  |  | VCCINT |  |  |  |  |  |  |  | 1.2
K12 |  |  | GND
K13 |  |  | VCCINT |  |  |  |  |  |  |  | 1.2
K14 |  |  | GND
K15 |  |  | VCCAUX |  |  |  |  |  |  |  | 3.3
K16 | dds_logic_address<0> | IOB | IO_L21P_1 | OUTPUT | LVCMOS33 | 1 | 12 | SLOW |  |  |  | LOCATED | NO | NONE
K17 | dds_logic_fifo_empty | IOB | IO_L36N_A8_M1BA1_1 | OUTPUT | LVCMOS33 | 1 | 12 | SLOW |  |  |  | LOCATED | NO | NONE
K18 | logic_out<31> | IOB | IO_L61N_1 | OUTPUT | LVCMOS33 | 1 | 12 | SLOW |  |  |  | LOCATED | NO | NONE
K19 |  | IOBS | IO_L40N_GCLK10_M1A6_1 | UNUSED |  | 1
K20 |  | IOBM | IO_L40P_GCLK11_M1A5_1 | UNUSED |  | 1
K21 | dds_logic_data_out<4> | IOB | IO_L44P_A3_M1DQ6_1 | OUTPUT | LVCMOS33 | 1 | 12 | SLOW |  |  |  | LOCATED | NO | NONE
K22 | dds_logic_data_out<6> | IOB | IO_L44N_A2_M1DQ7_1 | OUTPUT | LVCMOS33 | 1 | 12 | SLOW |  |  |  | LOCATED | NO | NONE
L1 |  | IOBS | IO_L39N_M3LDQSN_3 | UNUSED |  | 3
L2 |  |  | VCCO_3 |  |  | 3 |  |  |  |  | any******
L3 |  | IOBM | IO_L39P_M3LDQS_3 | UNUSED |  | 3
L4 |  | IOBS | IO_L42N_GCLK24_M3LDM_3 | UNUSED |  | 3
L5 |  |  | GND
L6 |  | IOBS | IO_L25N_3 | UNUSED |  | 3
L7 |  |  | VCCO_3 |  |  | 3 |  |  |  |  | any******
L8 |  |  | VCCAUX |  |  |  |  |  |  |  | 3.3
L9 |  |  | GND
L10 |  |  | VCCINT |  |  |  |  |  |  |  | 1.2
L11 |  |  | GND
L12 |  |  | VCCINT |  |  |  |  |  |  |  | 1.2
L13 |  |  | GND
L14 |  |  | VCCINT |  |  |  |  |  |  |  | 1.2
L15 | dds_logic_address<2> | IOB | IO_L58N_1 | OUTPUT | LVCMOS33 | 1 | 12 | SLOW |  |  |  | LOCATED | NO | NONE
L16 |  |  | VCCO_1 |  |  | 1 |  |  |  |  | 3.30
L17 |  | IOBM | IO_L61P_1 | UNUSED |  | 1
L18 |  |  | GND
L19 | dds_logic_data_out<10> | IOB | IO_L42N_GCLK6_TRDY1_M1LDM_1 | OUTPUT | LVCMOS33 | 1 | 12 | SLOW |  |  |  | LOCATED | NO | NONE
L20 | dds_logic_data_out<9> | IOB | IO_L45P_A1_M1LDQS_1 | OUTPUT | LVCMOS33 | 1 | 12 | SLOW |  |  |  | LOCATED | NO | NONE
L21 |  |  | VCCO_1 |  |  | 1 |  |  |  |  | 3.30
L22 | dds_logic_data_out<11> | IOB | IO_L45N_A0_M1LDQSN_1 | OUTPUT | LVCMOS33 | 1 | 12 | SLOW |  |  |  | LOCATED | NO | NONE
M1 |  | IOBS | IO_L38N_M3DQ3_3 | UNUSED |  | 3
M2 |  | IOBM | IO_L38P_M3DQ2_3 | UNUSED |  | 3
M3 |  | IOBM | IO_L42P_GCLK25_TRDY2_M3UDM_3 | UNUSED |  | 3
M4 |  | IOBS | IO_L31N_VREF_3 | UNUSED |  | 3
M5 |  | IOBM | IO_L31P_3 | UNUSED |  | 3
M6 |  | IOBM | IO_L25P_3 | UNUSED |  | 3
M7 |  | IOBM | IO_L23P_3 | UNUSED |  | 3
M8 |  | IOBS | IO_L23N_3 | UNUSED |  | 3
M9 |  |  | VCCINT |  |  |  |  |  |  |  | 1.2
M10 |  |  | GND
M11 |  |  | VCCINT |  |  |  |  |  |  |  | 1.2
M12 |  |  | GND
M13 |  |  | VCCINT |  |  |  |  |  |  |  | 1.2
M14 |  |  | GND
M15 |  |  | VCCAUX |  |  |  |  |  |  |  | 3.3
M16 | dds_logic_address<1> | IOB | IO_L58P_1 | OUTPUT | LVCMOS33 | 1 | 12 | SLOW |  |  |  | LOCATED | NO | NONE
M17 |  | IOBM | IO_L71P_1 | UNUSED |  | 1
M18 |  | IOBS | IO_L71N_1 | UNUSED |  | 1
M19 |  | IOBM | IO_L53P_1 | UNUSED |  | 1
M20 | dds_logic_data_out<8> | IOB | IO_L42P_GCLK7_M1UDM_1 | OUTPUT | LVCMOS33 | 1 | 12 | SLOW |  |  |  | LOCATED | NO | NONE
M21 | dds_logic_data_out<13> | IOB | IO_L46P_FCS_B_M1DQ2_1 | OUTPUT | LVCMOS33 | 1 | 12 | SLOW |  |  |  | LOCATED | NO | NONE
M22 | dds_logic_data_out<15> | IOB | IO_L46N_FOE_B_M1DQ3_1 | OUTPUT | LVCMOS33 | 1 | 12 | SLOW |  |  |  | LOCATED | NO | NONE
N1 |  | IOBS | IO_L37N_M3DQ1_3 | UNUSED |  | 3
N2 |  |  | GND
N3 |  | IOBM | IO_L37P_M3DQ0_3 | UNUSED |  | 3
N4 |  | IOBS | IO_L26N_3 | UNUSED |  | 3
N5 |  |  | VCCO_3 |  |  | 3 |  |  |  |  | any******
N6 |  | IOBM | IO_L11P_3 | UNUSED |  | 3
N7 |  | IOBS | IO_L11N_3 | UNUSED |  | 3
N8 |  |  | VCCAUX |  |  |  |  |  |  |  | 3.3
N9 |  |  | GND
N10 |  |  | VCCINT |  |  |  |  |  |  |  | 1.2
N11 |  |  | GND
N12 |  |  | VCCINT |  |  |  |  |  |  |  | 1.2
N13 |  |  | GND
N14 |  |  | VCCINT |  |  |  |  |  |  |  | 1.2
N15 |  |  | SUSPEND
N16 |  | IOBS | IO_L72N_1 | UNUSED |  | 1
N17 |  |  | GND
N18 |  |  | VCCO_1 |  |  | 1 |  |  |  |  | 3.30
N19 |  | IOBS | IO_L53N_VREF_1 | UNUSED |  | 1
N20 | dds_logic_data_out<12> | IOB | IO_L47P_FWE_B_M1DQ0_1 | OUTPUT | LVCMOS33 | 1 | 12 | SLOW |  |  |  | LOCATED | NO | NONE
N21 |  |  | GND
N22 | dds_logic_data_out<14> | IOB | IO_L47N_LDC_M1DQ1_1 | OUTPUT | LVCMOS33 | 1 | 12 | SLOW |  |  |  | LOCATED | NO | NONE
P1 |  | IOBS | IO_L36N_M3DQ9_3 | UNUSED |  | 3
P2 |  | IOBM | IO_L36P_M3DQ8_3 | UNUSED |  | 3
P3 |  | IOBM | IO_L26P_3 | UNUSED |  | 3
P4 |  | IOBS | IO_L24N_3 | UNUSED |  | 3
P5 |  | IOBS | IO_L8N_3 | UNUSED |  | 3
P6 |  | IOBM | IO_L8P_3 | UNUSED |  | 3
P7 |  | IOBS | IO_L7N_3 | UNUSED |  | 3
P8 |  | IOBM | IO_L7P_3 | UNUSED |  | 3
P9 |  |  | VCCINT |  |  |  |  |  |  |  | 1.2
P10 |  |  | GND
P11 |  |  | VCCINT |  |  |  |  |  |  |  | 1.2
P12 |  |  | GND
P13 |  |  | VCCINT |  |  |  |  |  |  |  | 1.2
P14 |  |  | GND
P15 |  |  | NC
P16 |  |  | NC
P17 |  | IOBM | IO_L72P_1 | UNUSED |  | 1
P18 |  | IOBM | IO_L73P_1 | UNUSED |  | 1
P19 |  | IOBM | IO_L59P_1 | UNUSED |  | 1
P20 |  | IOBS | IO_L59N_1 | UNUSED |  | 1
P21 | dds_logic_fifo_rd_clk | IOB | IO_L48P_HDC_M1DQ8_1 | INPUT | LVCMOS33 | 1 |  |  |  | NONE |  | LOCATED | NO | NONE
P22 |  | IOBS | IO_L48N_M1DQ9_1 | UNUSED |  | 1
R1 |  | IOBS | IO_L35N_M3DQ11_3 | UNUSED |  | 3
R2 |  |  | VCCO_3 |  |  | 3 |  |  |  |  | any******
R3 |  | IOBM | IO_L35P_M3DQ10_3 | UNUSED |  | 3
R4 |  | IOBM | IO_L24P_3 | UNUSED |  | 3
R5 |  |  | GND
R6 |  |  | VCCAUX |  |  |  |  |  |  |  | 3.3
R7 |  | IOBS | IO_L60N_2 | UNUSED |  | 2
R8 |  | IOBS | IO_L59N_2 | UNUSED |  | 2
R9 |  | IOBM | IO_L59P_2 | UNUSED |  | 2
R10 |  |  | VCCAUX |  |  |  |  |  |  |  | 3.3
R11 |  | IOBM | IO_L40P_2 | UNUSED |  | 2
R12 |  |  | VCCAUX |  |  |  |  |  |  |  | 3.3
R13 |  | IOBS | IO_L23N_2 | UNUSED |  | 2
R14 |  |  | VCCINT |  |  |  |  |  |  |  | 1.2
R15 |  | IOBS | IO_L10N_2 | UNUSED |  | 2
R16 |  | IOBM | IO_L10P_2 | UNUSED |  | 2
R17 |  |  | NC
R18 |  |  | GND
R19 |  | IOBS | IO_L73N_1 | UNUSED |  | 1
R20 | dds_logic_fifo_rd_en | IOB | IO_L49P_M1DQ10_1 | INPUT | LVCMOS33 | 1 |  |  |  | NONE |  | LOCATED | NO | NONE
R21 |  |  | VCCO_1 |  |  | 1 |  |  |  |  | 3.30
R22 | dds_logic_fifo_rd_done | IOB | IO_L49N_M1DQ11_1 | INPUT | LVCMOS33 | 1 |  |  |  | NONE |  | LOCATED | NO | NONE
T1 |  | IOBS | IO_L34N_M3UDQSN_3 | UNUSED |  | 3
T2 |  | IOBM | IO_L34P_M3UDQS_3 | UNUSED |  | 3
T3 |  | IOBS | IO_L9N_3 | UNUSED |  | 3
T4 |  | IOBM | IO_L9P_3 | UNUSED |  | 3
T5 |  | IOBS | IO_L65N_CSO_B_2 | UNUSED |  | 2
T6 |  | IOBM | IO_L65P_INIT_B_2 | UNUSED |  | 2
T7 |  | IOBM | IO_L60P_2 | UNUSED |  | 2
T8 |  | IOBM | IO_L51P_2 | UNUSED |  | 2
T9 |  |  | VCCO_2 |  |  | 2 |  |  |  |  | 3.30
T10 |  | IOBM | IO_L52P_2 | UNUSED |  | 2
T11 |  | IOBS | IO_L40N_2 | UNUSED |  | 2
T12 |  | IOBM | IO_L22P_2 | UNUSED |  | 2
T13 |  |  | VCCO_2 |  |  | 2 |  |  |  |  | 3.30
T14 |  | IOBM | IO_L23P_2 | UNUSED |  | 2
T15 |  | IOBS | IO_L7N_2 | UNUSED |  | 2
T16 |  | IOBM | IO_L7P_2 | UNUSED |  | 2
T17 |  | IOBS | IO_L4N_VREF_2 | UNUSED |  | 2
T18 |  | IOBM | IO_L4P_2 | UNUSED |  | 2
T19 |  | IOBM | IO_L74P_AWAKE_1 | UNUSED |  | 1
T20 |  | IOBS | IO_L74N_DOUT_BUSY_1 | UNUSED |  | 1
T21 |  | IOBM | IO_L50P_M1UDQS_1 | UNUSED |  | 1
T22 |  | IOBS | IO_L50N_M1UDQSN_1 | UNUSED |  | 1
U1 |  | IOBS | IO_L33N_M3DQ13_3 | UNUSED |  | 3
U2 |  |  | GND
U3 |  | IOBM | IO_L33P_M3DQ12_3 | UNUSED |  | 3
U4 |  | IOBM | IO_L10P_3 | UNUSED |  | 3
U5 |  |  | VCCO_3 |  |  | 3 |  |  |  |  | any******
U6 |  | IOBM | IO_L63P_2 | UNUSED |  | 2
U7 |  |  | GND
U8 |  | IOBS | IO_L51N_2 | UNUSED |  | 2
U9 |  | IOBM | IO_L50P_2 | UNUSED |  | 2
U10 |  | IOBS | IO_L52N_2 | UNUSED |  | 2
U11 |  |  | VCCAUX |  |  |  |  |  |  |  | 3.3
U12 |  | IOBS | IO_L22N_2 | UNUSED |  | 2
U13 | hi_inout<13> | IOB | IO_L12N_D2_MISO3_2 | BIDIR | LVCMOS33 | 2 | 12 | SLOW |  | NONE |  | LOCATED | YES | NONE
U14 | hi_inout<14> | IOB | IO_L12P_D1_MISO2_2 | BIDIR | LVCMOS33 | 2 | 12 | SLOW |  | NONE |  | LOCATED | YES | NONE
U15 |  | IOBM | IO_L13P_M1_2 | UNUSED |  | 2
U16 |  | IOBS | IO_L8N_2 | UNUSED |  | 2
U17 |  | IOBM | IO_L8P_2 | UNUSED |  | 2
U18 |  |  | VCCO_1 |  |  | 1 |  |  |  |  | 3.30
U19 |  | IOBM | IO_L70P_1 | UNUSED |  | 1
U20 |  | IOBM | IO_L51P_M1DQ12_1 | UNUSED |  | 1
U21 |  |  | GND
U22 |  | IOBS | IO_L51N_M1DQ13_1 | UNUSED |  | 1
V1 |  | IOBS | IO_L32N_M3DQ15_3 | UNUSED |  | 3
V2 |  | IOBM | IO_L32P_M3DQ14_3 | UNUSED |  | 3
V3 |  | IOBS | IO_L10N_3 | UNUSED |  | 3
V4 |  |  | GND
V5 |  | IOBS | IO_L63N_2 | UNUSED |  | 2
V6 |  |  | VCCAUX |  |  |  |  |  |  |  | 3.3
V7 |  | IOBS | IO_L46N_2 | UNUSED |  | 2
V8 |  |  | VCCO_2 |  |  | 2 |  |  |  |  | 3.30
V9 |  | IOBS | IO_L50N_2 | UNUSED |  | 2
V10 |  |  | GND
V11 |  | IOBM | IO_L42P_2 | UNUSED |  | 2
V12 |  |  | VCCO_2 |  |  | 2 |  |  |  |  | 3.30
V13 |  | IOBM | IO_L18P_2 | UNUSED |  | 2
V14 |  |  | GND
V15 | hi_inout<5> | IOB | IO_L13N_D10_2 | BIDIR | LVCMOS33 | 2 | 12 | SLOW |  | NONE |  | LOCATED | YES | NONE
V16 |  |  | VCCO_2 |  |  | 2 |  |  |  |  | 3.30
V17 |  | IOBM | IO_L11P_2 | UNUSED |  | 2
V18 |  | IOBS | IO_L9N_2 | UNUSED |  | 2
V19 |  | IOBM | IO_L9P_2 | UNUSED |  | 2
V20 |  | IOBS | IO_L70N_1 | UNUSED |  | 1
V21 |  | IOBM | IO_L52P_M1DQ14_1 | UNUSED |  | 1
V22 |  | IOBS | IO_L52N_M1DQ15_1 | UNUSED |  | 1
W1 |  | IOBS | IO_L2N_3 | UNUSED |  | 3
W2 |  |  | VCCO_3 |  |  | 3 |  |  |  |  | any******
W3 |  | IOBM | IO_L2P_3 | UNUSED |  | 3
W4 | hi_inout<10> | IOB | IO_L62P_D5_2 | BIDIR | LVCMOS33 | 2 | 12 | SLOW |  | NONE |  | LOCATED | YES | NONE
W5 |  |  | VCCO_2 |  |  | 2 |  |  |  |  | 3.30
W6 |  | IOBM | IO_L53P_2 | UNUSED |  | 2
W7 |  |  | GND
W8 |  | IOBM | IO_L46P_2 | UNUSED |  | 2
W9 |  | IOBM | IO_L47P_2 | UNUSED |  | 2
W10 |  | IOBM | IO_L44P_2 | UNUSED |  | 2
W11 | hi_aa | IOB | IO_L42N_2 | BIDIR | LVCMOS33 | 2 | 12 | SLOW |  | NONE |  | LOCATED | NO | NONE
W12 |  | IOBM | IO_L29P_GCLK3_2 | UNUSED |  | 2
W13 |  | IOBS | IO_L18N_2 | UNUSED |  | 2
W14 |  | IOBM | IO_L20P_2 | UNUSED |  | 2
W15 |  | IOBS | IO_L17N_2 | UNUSED |  | 2
W16 |  |  | GND
W17 |  | IOBS | IO_L11N_2 | UNUSED |  | 2
W18 |  | IOBM | IO_L6P_2 | UNUSED |  | 2
W19 |  |  | GND
W20 |  | IOBM | IO_L60P_1 | UNUSED |  | 1
W21 |  |  | VCCO_1 |  |  | 1 |  |  |  |  | 3.30
W22 |  | IOBS | IO_L60N_1 | UNUSED |  | 1
Y1 |  | IOBS | IO_L1N_VREF_3 | UNUSED |  | 3
Y2 |  | IOBM | IO_L1P_3 | UNUSED |  | 3
Y3 | hi_in<6> | IOB | IO_L58P_2 | INPUT | LVCMOS33 | 2 |  |  |  | NONE |  | LOCATED | NO | NONE
Y4 | hi_inout<9> | IOB | IO_L62N_D6_2 | BIDIR | LVCMOS33 | 2 | 12 | SLOW |  | NONE |  | LOCATED | YES | NONE
Y5 |  | IOBM | IO_L54P_2 | UNUSED |  | 2
Y6 |  | IOBS | IO_L53N_2 | UNUSED |  | 2
Y7 | hi_inout<8> | IOB | IO_L48P_D7_2 | BIDIR | LVCMOS33 | 2 | 12 | SLOW |  | NONE |  | LOCATED | YES | NONE
Y8 |  | IOBS | IO_L47N_2 | UNUSED |  | 2
Y9 | i2c_scl | IOB | IO_L43P_2 | TRISTATE | LVCMOS33 | 2 | 12 | SLOW | PULLUP |  |  | LOCATED | NO | NONE
Y10 |  | IOBS | IO_L44N_2 | UNUSED |  | 2
Y11 |  | IOBM | IO_L32P_GCLK29_2 | UNUSED |  | 2
Y12 | hi_in<0> | IOB | IO_L29N_GCLK2_2 | INPUT | LVCMOS33 | 2 |  |  |  | NONE |  | LOCATED | NO | NONE
Y13 | hi_inout<2> | IOB | IO_L30P_GCLK1_D13_2 | BIDIR | LVCMOS33 | 2 | 12 | SLOW |  | NONE |  | LOCATED | YES | NONE
Y14 |  | IOBS | IO_L20N_2 | UNUSED |  | 2
Y15 |  | IOBM | IO_L21P_2 | UNUSED |  | 2
Y16 |  | IOBM | IO_L17P_2 | UNUSED |  | 2
Y17 | led<0> | IOB | IO_L15P_2 | OUTPUT | LVCMOS33 | 2 | 12 | SLOW |  |  |  | LOCATED | NO | NONE
Y18 |  | IOBS | IO_L6N_2 | UNUSED |  | 2
Y19 | hi_out<0> | IOB | IO_L5P_2 | OUTPUT | LVCMOS33 | 2 | 12 | SLOW |  |  |  | LOCATED | NO | NONE
Y20 |  |  | CMPCS_B_2
Y21 |  | IOBM | IO_L1P_CCLK_2 | UNUSED |  | 2
Y22 |  |  | DONE_2
# ----- | ----- | ----- | ----- | ----- | ----- | ----- | ----- | ----- | ----- | ----- | ----- | ----- | ----- | -----
#
#* Default value.
#** This default Pullup/Pulldown value can be overridden in Bitgen.
#****** Special VCCO requirements may apply. Please consult the device
# family datasheet for specific guideline on VCCO requirements.
#
#
#
