Arvad/YbDDSControl/DDSbox/PCB_designs/DDS_2016_files_for_ordering/parts_list.xls

Sheet: 入力方法と記入例
データ登録時の注意事項
設計サービスは、実装する電子部品型番よりデータシートを検索し記載された部品外形サイズより、基板設計ＣＡＤで配置・配線に使用する
部品（フットプリント）を作成します。
電子部品型番が特定できないと、部品（フットプリント）が特定できず、設計作業を進めることができなくなります。
また、電子部品型番が誤っていると、部品実装時に部品同士が干渉し実装できない場合がございます。
実装サービスは、無料提供部品を除く実装部品をお客様よりご提供いただき、ご登録いただく「部品リスト」をもとに部品入荷検品を行います。
ご登録いただいた資料を「正」として作業を進めますので、間違いがないかご登録時に再度資料のご確認をお願いします。
入力方法
 | No. |  |  | 連番
 | 設計/実装 サービス共通 | メーカー名 |  | 電子部品のメーカー名を入力してください。
 |  | 電子部品型番 （必須・半角英数字） |  | ※面実装部品のコンデンサ(電解、タンタル以外)や抵抗は、外形寸法に従い、後述「設計サービス指示図２」の部品名称を入力していただければ「メーカー名」は不要です。
 |  | 個数 （必須・半角英数字） |  | 「電子部品型番」の種類毎の実装個数を入力してください。 未実装は「未実装」と入力してください。
 | 設計サービスのみ | 回路記号 （必須・半角英数字） |  | ※複数の回路記号を入力する場合は、カンマ「,」区切りで入力してください。
 |  | ピン数 （必須・半角英数字） |  | 端子の総ピン数を入力してください。※基板取付穴、部品取付穴、全てのスルー・ノンスルーホール、面実装部品のパッド、及び次の①～⑤の配線を伴う箇所（①テストピン、②チェックランド、③引き出しランド、④ジャンパピン、⑤入出力ランドの総計。
 | 実装サービスのみ | 配置番号 （必須・半角英数字） |  | シルク図/配置図に表記された記号/番号を入力してください。
 |  | パッケージ 情報 | 部品外形 | 「0-MR4/NM」「0.1u/p」など
 |  |  | 部品仕様 | 「1608」「1005」など
 |  | お客様 支給 部品 | SMD品 | 表面実装部品
 |  |  | BGA/CSP/LGA /QFN/HQFP | BGA/CSP、LGA/QFN部品が含まれている場合に☑してください。 ＢＧＡ：Ball Grid Array 下面に半田ボールの端子を配置したパッケージ。 ＣＳＰ：Ｃｈｉｐ Ｓｉｚｅ Ｐａｃｋａｇｅ／Ｃｈｉｐ Ｓｃａｌｅ Ｐａｃｋａｇｅ チップサイズと同じか、もしくはわずかに 大きいパッケージ。 LGA：Land Grid Array 裏面に外部入出力用のランドを設けたパッケージ。BGAの半田ボールが ない状態。 QFN：QFPに似ていますが、外部入出力用のピンが出ていないパッケージ。
 |  | 無料提供部品 |  | 無料提供部品が含まれている場合に☑してください。 無料提供部品：チップコンデンサ/チップ抵抗を約1500種、実装サービスをご利用のお客様に無料提供いたします。
 |  |  |  | http://www.p-ban.com/implementation/chip.html
 |  | P板.com調達部品 |  | 調達希望部品が含まれている場合に☑してください。 P板.com調達部品は、無料提供部品以外に弊社での調達を希望される部品のことです。 ※調達費用のお見積もりは、部品リストの返却と同時にご連絡いたします。 ※納期によっては調達できない部品もございますので、予めご了承ください。
 |  |  | 調達不可 | P板.com調達部品で調達が不可となった部品は、見積回答時に弊社で☑いたします。 ※お客様の方で、ご記入する必要はございません。
 |  | 代替部品 |  | 無料提供部品の在庫切れや、P板.com調達部品で調達不可となった部品に対して、弊社より代替部品としてご提案させていただきます。
記入例
設計サービス指示図１
コネクターの場合 |  |  |  |  |  | トランスの場合
設計サービス指示図２
１．チップ部品（抵抗、コンデンサ）
 |  |  |  |  | 単位：ｍｍ
 | 部品タイプ | Ａ寸法 | Ｂ寸法 | 抵抗 電子部品型番 | コンデンサ 電子部品型番
 | １６０８タイプ | 1.6 | 0.8 | R1608 | C1608
 | ２１２５タイプ | 2 | 1.25 | R2125 | C2125
 | ３２１６タイプ | 3.2 | 1.6 | R3216 | C3216
 | ３２２５タイプ | 3.2 | 2.5 | R3225 | C3225
 | ４５３２タイプ | 4.5 | 3.2 | R4532 | C4532
２．チップタンタルコンデンサ
 |  |  |  | 単位：ｍｍ
 | 部品タイプ | Ａ寸法 | Ｂ寸法 | 電子部品型番
 | ３２１６タイプ | 3.2 | 1.6 | CT3216
 | ３５２８タイプ | 3.5 | 2.8 | CT3528
 | ４７２６タイプ | 4.7 | 2.6 | CT4726
 | ６０３２タイプ | 6 | 3.2 | CT6032
 | ５８４６タイプ | 5.8 | 4.6 | CT5846
 | ７３４３タイプ | 7.3 | 4.3 | CT7343
３．チップアルミ電解コンデンサ
 |  |  |  |  |  | 単位：ｍｍ
 | 外形サイズ |  | Ａ寸法 | Ｂ寸法 | C寸法 | 電子部品型番
 | ３．３×３．３ |  | 3.3 | 3.3 | φ３．０ | CE33
 | ４．３×４．３ |  | 4.3 | 4.3 | φ４．０ | CE43
 | ５．３×５．３ |  | 5.3 | 5.3 | φ５．０ | CE53
 | ６．６×６．６ |  | 6.6 | 6.6 | φ６．３ | CE66
 | ８．３×８．３ |  | 8.3 | 8.3 | φ８．０ | CE83
 | １０．３×１０．３ |  | 10.3 | 10.3 | φ１０.０ | CE103

Sheet: 部品リスト入力フォーム
No. | 共通 |  |  |  | 設計サービスのみ |  |  | 実装サービスのみ
 | メーカー名 | 部品名称 | 電 子 部 品 型 番 （半角英数字） | 個数 | 回 路 記 号 （半角英数字） | ピ ン 数 (部品取付穴 を含む） |  | 配 置 番 号 （半角英数字） 回路記号と同じなら不要 | 実装 個数 | 実装枚数を入力してください。↓ | パッケージ情報 (部品外形/部品仕様) | お客様支給部品 |  | 無料 提供 部品 | P板.com 調達 部品 (有料） |  | 代替部品 |  | 入荷数 | 返却
 |  |  |  |  |  |  |  |  |  |  |  | SMD品 | BGA /CSP /LGA /QFN /HQFP |  |  | 調達 不可
 |  |  |  |  |  | 1個 あたり | 合計 |  |  |  |  |  |  |  |  |  | メーカー名 | 型名
 |  |  |  | 154 |  | 0 | 0 |  | 154 | 40 |  |  |  | リスト (http://www.p-ban.com/implementation/chip.html)
1 | MURATA | チップコンデンサ | GRM21BB11E104K | 59 |  |  |  | C1-C10, C15-C21, C24-C37, C40, C41, C44, C45, C48, C49, C52, C53, C58-C62, C65-C75, C82-C84, C88 | 59 | 2360 | C2012/25V, 100nF
2 | MURATA | チップコンデンサ | GRM216C1H100JZ01D | 4 |  |  |  | C11-C14 | 4 | 160 | C2012/50V, 10pF
3 | Vishay Dale | チップコンデンサ | 399-9254-1-ND | 1 |  |  |  | C22 | 1 | 40 | C2012/50V, 560pF
4 | MURATA | チップコンデンサ | GRM2162C1H471J | 1 |  |  |  | C23 | 1 | 40 | C2012/50V, 470pF
5 | MURATA | チップコンデンサ | GRM2162C1H101J | 2 |  |  |  | C76, C87 | 2 | 80 | C2012/50V, 100pF
6 | Vishay Dale | チップコンデンサ | 399-5706-1-ND | 2 |  |  |  | C77, C78 | 2 | 80 | C2012/25V, 10nF
7 | MURATA | チップコンデンサ | GRM219B11H333K | 3 |  |  |  | C79-C81 | 3 | 120 | C2012/50V, 33nF
8 | Vishay Dale | チップコンデンサ | 399-1130-1-ND | 5 |  |  |  | C89-C93 | 5 | 200 | C2012/50V, 330pF
9 | Kemet | タンタルコンデンサ | T491B106M025AT | 14 |  |  |  | C38, C39, C42, C43, C46, C47, C50, C51, C54-C57, C63, C64 | 14 | 560 | Tantalum polarized SMD capacitor 10uF
10 | TDK | ショットキーダイオード | 1PS76SB17 | 4 |  |  |  | D1-D4 | 4 | 160 | SOD323
11 | TOSHIBA | LED | SML-LX1206IC-TR | 8 |  |  |  | D5-D12 | 8 | 20 | DSO-C2/D5.6
12 | KOA | チップ抵抗 | RHM10.0KCJCT-ND | 14 |  |  |  | R1-R7, R10, R14, R16-R19, R21 | 14 | 560 | R3216/10kΩ 0.25W
13 | Vishay Dale | チップ抵抗 | 541-3.30KFCT-ND | 1 |  |  |  | R8 | 1 | 40 | R3216/3.3kΩ 0.25W
14 | Vishay Dale | チップ抵抗 | 541-4.02KFCT-ND | 1 |  |  |  | R9 | 1 | 40 | R3216/4.02kΩ 0.25W
15 | KOA | チップ抵抗 | RK73B2BTTD472J | 1 |  |  |  | R11 | 1 | 40 | R3216/4.7kΩ 0.25W
16 | Vishay Dale | チップ抵抗 | 541-75.0FCT-ND | 2 |  |  |  | R12, R15 | 2 | 80 | R3216/75Ω 0.25W
17 | KOA | チップ抵抗 | RK73B2BTTD242J | 1 |  |  |  | R13 | 1 | 40 | R3216/2.4kΩ 0.25W
18 | Vishay Dale | チップ抵抗 | 541-49.9FCT-ND | 1 |  |  |  | R20 | 1 | 40 | R3216/49.9Ω 0.25W
19 | Vishay Dale | チップ抵抗 | 541-3.90KFCT-ND | 1 |  |  |  | R22 | 1 | 40 | R3216/3.9kΩ 0.25W
20 | MiniCircuits | トランス | TC1-1TX+ | 1 |  |  |  | T3 | 1 | 40 | TC1-1TX+
21 | Altera | FPGA | EP4CE22F17C8 | 1 |  |  |  | U1 | 1 | 40 | FBGA256
22 | Altera | EPCS4 Series, In-system programmable 3.3V serial configuration device, 8-Pin SOIC, 4-Megabit, Industrial Grade, Pb-Free | EPCS16SI8N | 1 |  |  |  | U2 | 1 | 40 | SOIC8_L
23 | Analog Device | Imported | AD9915BCPZ | 1 |  |  |  | U3 | 1 | 40 | CP_88_5
24 | Maxim | Differential Line Receivers | MAX3094 | 8 |  |  |  | U4-U6, U8-U10, U12, U20 | 8 | 320 | TSSOP16
25 | Maxim | Differential Line Transmitter | MAX3030 | 2 |  |  |  | U7, U11 | 2 | 80 | TSSOP16
26 | Texas | レギュレータ | LM1086IS-5.0 | 1 |  |  |  | U13 | 1 | 40 | TS3B_N
27 | Texas | レギュレータ | LM1086IS-3.3 | 2 |  |  |  | U14, U17 | 2 | 80 | TS3B_N
28 | Texas | レギュレータ | LM1086IS-1.8 | 2 |  |  |  | U15, U19 | 2 | 80 | TS3B_N
29 | Texas | レギュレータ | LM1086CS-2.5 | 1 |  |  |  | U16 | 1 | 40 | TS3B_N
30 | Texas | レギュレータ | LP2983AIM5-1.2 | 1 |  |  |  | U18 | 1 | 40 | MF05A_N
31 | Analog Device | DAC | AD9744ARUZ | 1 |  |  |  | U21 | 1 | 40 | TSOP65P640-28AM
32 | Analog Device | 可変ゲインアンプ | ADL5330 | 1 |  |  |  | U22 | 1 | 40 | QFN50P400X400-24VAN
33 | Texas | LEDドライバ | TLC5917 | 1 |  |  |  | U23 | 1 | 40 | SOIC16
34 | Citizen | 発信機 | CSX750FJC50.000MT | 1 |  |  |  | U25 | 1 | 40 | CSX750F
35 | MiniCircuits | フィルター | SALF-396 | 1 |  |  |  | U26 | 1 | 40 | SALF-396
36 | Kemet | チップコンデンサ | 399-8092-1-ND | 2 |  |  |  | C85, C86 | 2 | 80 | 47nF
37 | Liard | EMI shield | BMI-S-207-F | 1 |  |  |  | P5 | 1 | 40 | 1.7"x1.7" frame
38
39
40
41
42
43
44
45
46
47
48
49
50
51
52
53
54
55
56
57
58
59
60
61
62
63
64
65
66
67
68
69
70
71
72
73
74
75
76
77
78
79
80
81
82
83
84
85
86
87
88
89
90
91
92
93
94
95
96
97
98
99
100
101
102
103
104
105
106
107
108
109
110
111
112
113
114
115
116
117
118
119
120
121
122
123
124
125
126
127
128
129
130
131
132
133
134
135
136
137
138
139
140
141
142
143
144
145
146
147
148
149
150
151
152
153
154
155
156
157
158
159
160
161
162
163
164
165
166
167
168
169
170
171
172
173
174
175
176
177
178
179
180
181
182
183
184
185
186
187
188
189
190
191
192
193
194
195
196
197
198
199
200
201
202
203
