Arvad/YbDDSControl/DDSbox/PCB_designs/DDS_2016_files_for_ordering/製造資料/sample_data.xls

Sheet: ｶﾞｰﾊﾞｰﾌｫｰﾏｯﾄﾘｽﾄ
ガーバー形式をお選びください
データ内容 | ファイル名
ドリルデータ | DDS_RIKEN_2014.TXT, DDS_RIKEN_2014.DRR, DDS_RIKEN_2014.DRL
ドリルリスト | DDS_RIKEN_2014.TXT, DDS_RIKEN_2014.DRR, DDS_RIKEN_2014.DRL
ドリルデータ（分かれている場合）
ドリルリスト（分かれている場合）
部品面パターン | DDS_RIKEN_2014.GTL
半田面パターン | DDS_RIKEN_2014.GBL
部品面レジスト | DDS_RIKEN_2014.GTS
半田面レジスト | DDS_RIKEN_2014.GBS
部品面シルク | DDS_RIKEN_2014.GTO
半田面シルク | DDS_RIKEN_2014.GBO
外形線図 | DDS_RIKEN_2014.GKO
Ｌ２内層パターン（４，６，８層板のみ要） | DDS_RIKEN_2014.G1
Ｌ３内層パターン（４，６，８層板のみ要） | DDS_RIKEN_2014.G2
Ｌ４内層パターン（６，８層板のみ要）
Ｌ５内層パターン（６，８層板のみ要）
Ｌ６内層パターン（８層板のみ要）
Ｌ７内層パターン（８層板のみ要）

Sheet: ｱﾊﾟﾁｬﾘｽﾄ（Dｺｰﾄﾞ表）
※RS-274X（拡張ガーバー形式）で出力した場合は必要ございません。 本シートに入力せずデータファイルをご登録いただいても結構です。
Dコード | 形状 | サイズ1(X) | サイズ2(Y) | サイズ3(Z)
D10 | Round | 0.6 |  |  | Round=円形
D11 | Square | 0.6 |  |  | Square=四角
D12 | Rectangl | 0.6 | 2 |  | Rectangle=長方形
D13 | Oblong | 2 | 0.6 |  | Oblong＝楕円
D14 | Thermal | 2 | 1.5 | 0.2 | Thermal=サーマル
 |  |  |  |  | 長方形と楕円
 |  |  |  |  | サーマル
 |  |  |  |  |  | X
 |  |  |  |  |  | Y
 |  |  |  |  |  | Z

Sheet: 外形図
※外形寸法が入った外形図をご登録下さい。 本シートに貼り付けずデータファイルをご登録いただいても結構です。
