Arvad/YbDDSControl/DDSbox/PCB_designs/Drawing_for_box/2015_November/bottom_plate.dxf

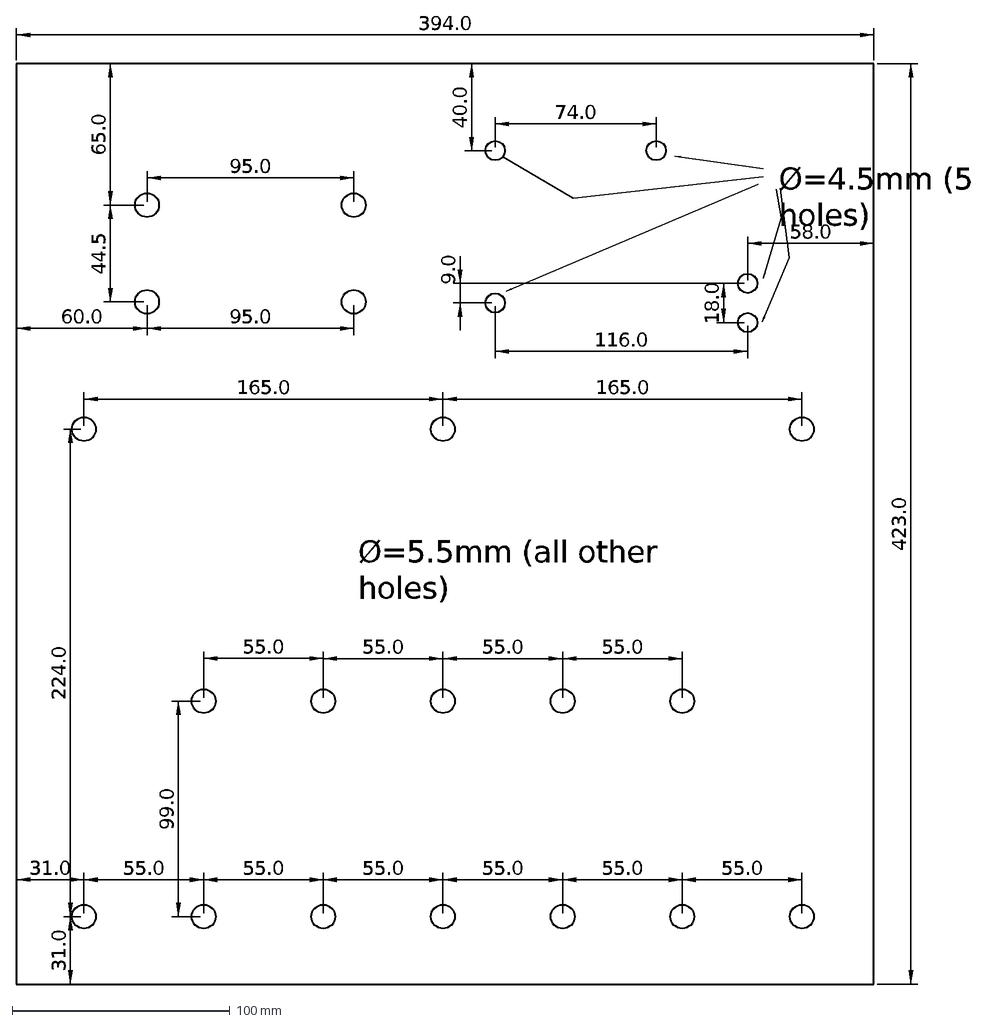
[picture p14: CAD file, 2016-08-04]
DDSbox/PCB_designs/Drawing_for_box/2015_November/bottom_plate.dxf
31.0
55.0
99.0
224.0
165.0
65.0
44.5
60.0
95.0
40.0
74.0
18.0
9.0
58.0
116.0
Ø=4.5mm (5 holes)
Ø=5.5mm (all other holes)
394.0
423.0
