Arvad/YbDDSControl/DDSbox/PCB_designs/Drawing_for_box/2015_November/rear_panel.dxf

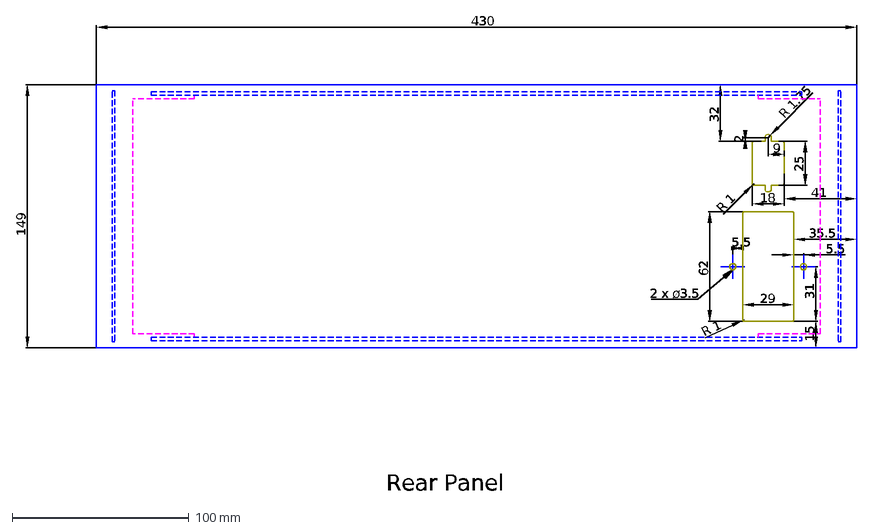
[picture p15: CAD file, 2016-08-04]
DDSbox/PCB_designs/Drawing_for_box/2015_November/rear_panel.dxf
149
430
Rear Panel
31
5.5
15
35.5
2 x ø3.5
R 1
62
29
18
41
32
9
2
R 1.75
25
