Arvad/YbDDSControl/DDSbox/PCB_designs/Drawing_for_box/2015_November/front_panel.dxf

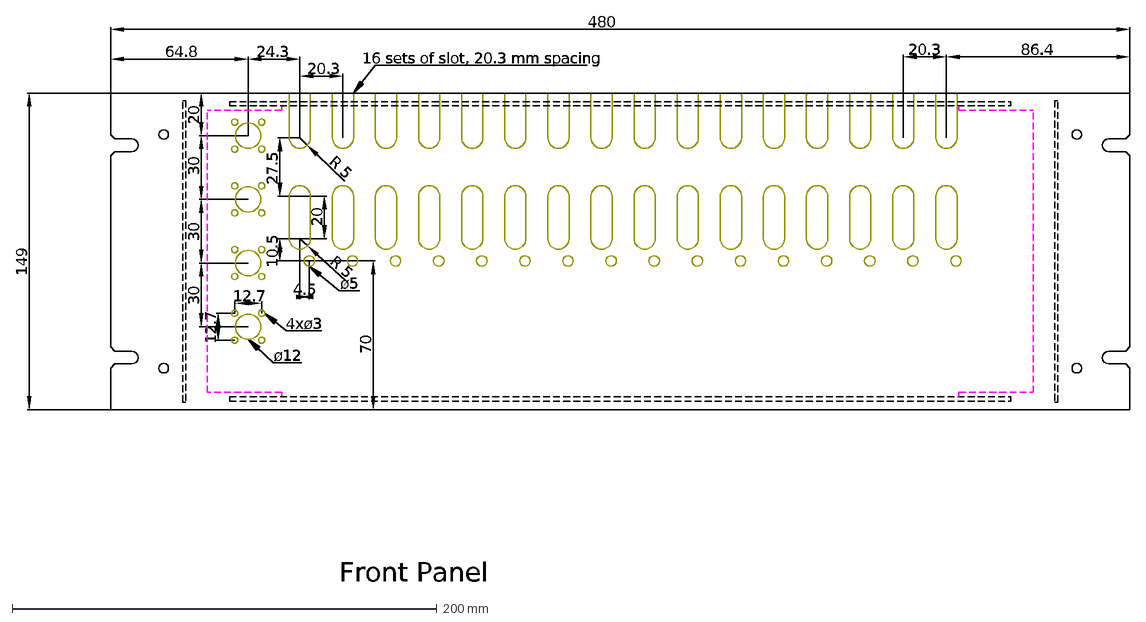
[picture p16: CAD file, 2016-08-04]
DDSbox/PCB_designs/Drawing_for_box/2015_November/front_panel.dxf
Front Panel
70
20.3
86.4
16 sets of slot, 20.3 mm spacing
64.8
30
20
24.3
12.7
4xø3
ø12
R 5
4.5
27.5
10.5
ø5
149
480
