Arvad/YbDDSControl/(list of files, cad)

Other CAD files:
DDSbox/VHDL_files/DDS_FPGA_2016_05_24/db/stp1_auto_stripped.stp
DDSbox/VHDL_files/DDS_FPGA_2016_05_24/output_files/stp1.stp
