Arvad/YbDDSControl/(list of files, drawings)

Other design files:
DDSbox/PCB_designs/Breakout_board/2014_November/BreakOutBoard_Cyclone.PrjPcb
DDSbox/PCB_designs/Breakout_board/2014_November/BreakOutBoard_Cyclone.SchDoc
DDSbox/PCB_designs/Breakout_board/2015_May/BreakOutBoard_Cyclone.PrjPcb
DDSbox/PCB_designs/Breakout_board/2015_May/BreakOutBoard_Cyclone.SchDoc
DDSbox/PCB_designs/Breakout_board/2015_November/BreakOutBoard_Cyclone.PrjPcb
DDSbox/PCB_designs/Breakout_board/2015_November/BreakOutBoard_Cyclone.SchDoc
DDSbox/PCB_designs/Breakout_board/2016_February/BreakOutBoard_Cyclone.PrjPcb
DDSbox/PCB_designs/Breakout_board/2016_February/BreakOutBoard_Cyclone.SchDoc
DDSbox/PCB_designs/DDS_board/2014_November/cyclone4.SchDoc
DDSbox/PCB_designs/DDS_board/2014_November/DDS_RIKEN_2014.PcbDoc
DDSbox/PCB_designs/DDS_board/2014_November/DDS_RIKEN_2014.PrjPcb
DDSbox/PCB_designs/DDS_board/2014_November/DDS_RIKEN_main.SchDoc
DDSbox/PCB_designs/DDS_board/2014_November/Power_supply.SchDoc
DDSbox/PCB_designs/DDS_board/2015_May/cyclone4.SchDoc
DDSbox/PCB_designs/DDS_board/2015_May/DDS_RIKEN_2014.PcbDoc
DDSbox/PCB_designs/DDS_board/2015_May/DDS_RIKEN_2014.PrjPcb
DDSbox/PCB_designs/DDS_board/2015_May/DDS_RIKEN_main.SchDoc
DDSbox/PCB_designs/DDS_board/2015_May/Power_supply.SchDoc
DDSbox/PCB_designs/DDS_board/2016_Feb/cyclone4.SchDoc
DDSbox/PCB_designs/DDS_board/2016_Feb/DDS_RIKEN_2014.PcbDoc
DDSbox/PCB_designs/DDS_board/2016_Feb/DDS_RIKEN_2014.PrjPcb
DDSbox/PCB_designs/DDS_board/2016_Feb/DDS_RIKEN_main.SchDoc
DDSbox/PCB_designs/DDS_board/2016_Feb/Power_supply.SchDoc
