Arvad/YbDDSControl/(commit log)

2016-08-04 Cleaned up the fork from pulse_sequencer Seperated the files into a sensible structure
    [BreakOutBoard_Cyclone.PrjPcb, BreakOutBoard_Cyclone.SchDoc, Components_list.xlsx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]
2016-09-01 Pyqtgraph was unstalbe - removed the threading - will test is if it fast enough without a graphicsthread Fixed a bug with parsing loops
2016-09-02 Cleaning - timing Stop button now effectivly stops
2016-09-06 Updated Timing structure so it now runs indefinetly and not on a trigger from parametervault. The running can be stopped by pressing stop button (Not tested) Updated parsing to make off pulses go to 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
2016-09-13 Wrote everything into twisted, with newspawning threads (NOT TESTED)
2016-09-15 Added a bunch of buttons Cleaned up some printing
2016-09-15 Added a flag for checking if the pulser has started Will be used to check if it has been triggered, but for consistensy it always go high if the pulser starts outputting
    [photon_pad.csv]
2016-09-16 Bugfixes: 1: A missing indent make the parser only program the last line of the parsed text 2:A wrong check in wait_for_sequence_started made the thing always wait the timeout period 3: Fixed the lin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
2016-09-26 Changed button look, so it now really looks like buttons
2016-09-27 Changed the color of the buttons to a more pleasing style (maybe)
2016-10-03 Fixed bugs in the sweeping process - it now behaves as expected On the FPGA side The conditioning of the step_to_next_frequency signal is now conditioned with clk_50 instead of clk_dds, meaning it sy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
    [stp1.stp, stp1_auto_stripped.stp]
2016-10-13 Made spectrum widget recognize param and para
2016-10-18 Fixed bug in pulse generation (forgot to turn the pulse off!) Added an update button (with a flashing warning) FIxed the bugs with the start?stop button when pressed multiple times Now keeps track of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
2016-10-21 Changed parsing to happen line by line (and profiled it to optimize speed) Changed the keyword structure Added support for frequency and amplitude ramping Added multiple modescripts so it can change 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
